busranurkocak/EE463-Term-Project/README.md

# EE463-Term-Project

Wind Turbine Controller (https://github.com/odtu/ee463/tree/master/Term%20Project)

Power Guide :Büşra Nur KOÇAK, Eren ÖZKARA, Yunus ÇAY
