busranurkocak/EE463-Term-Project/Reports/Presentationv3.pptx

## EE 463 Term Project Power guıde

Eren ÖZKARA
Büşra Nur KOÇAK
Yunus ÇAY

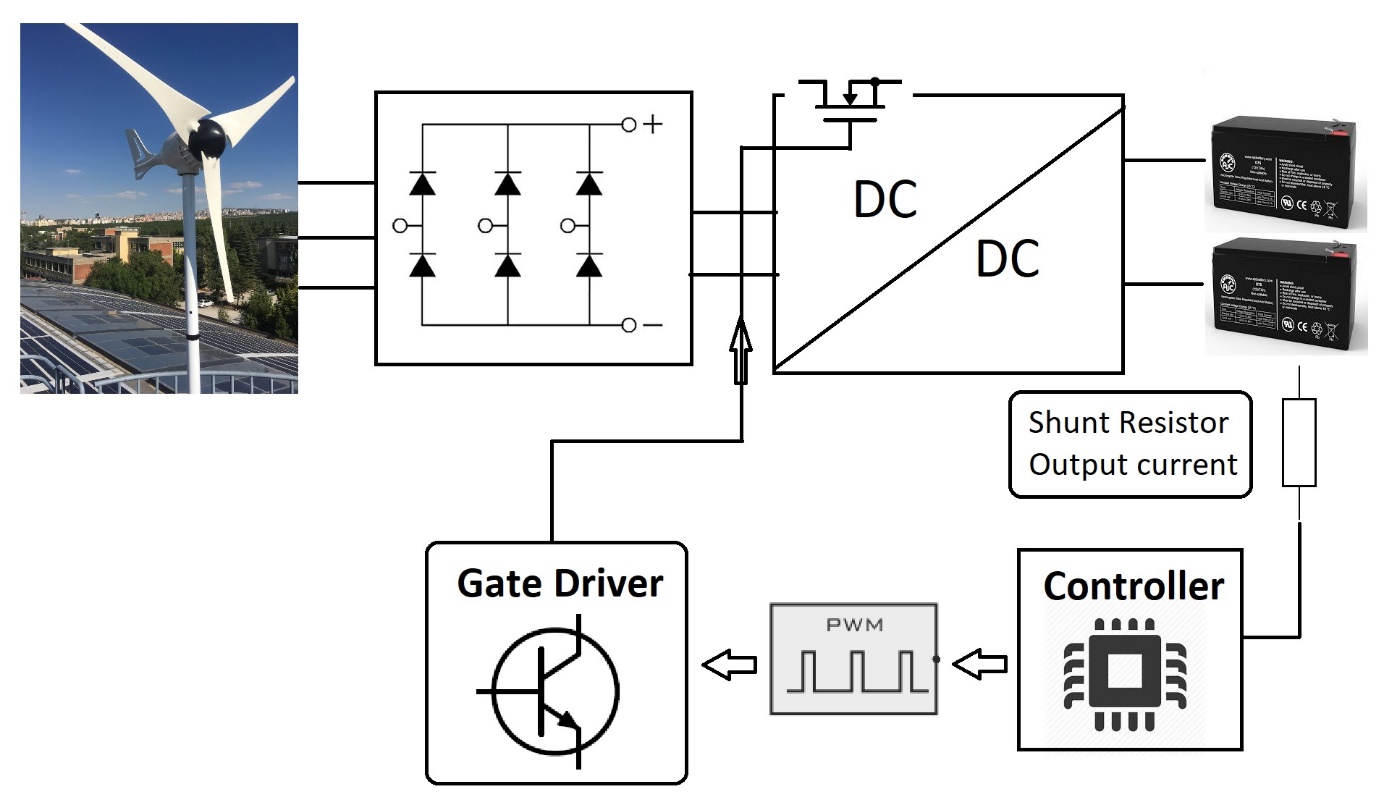
[picture p43: figure]

## ıNTRODUCTION

Topology Selection
Detailed Simulation
PCB Design
Component Selection
Conclusion

## Topology sELECTION

- Three Phase Thyristor Rectifier
+ Easy Topology Structure
+ Less Component
+ No Third Harmonics
- Expensive Components
- Six Gate Signals
- Complex Synchronous Control

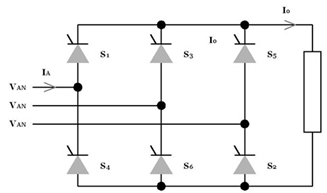
[picture p44: figure]
three-phase-full-wave-controlled-rectifier | AC-DC Power Converters | Electronics Tutorial || Electronics Tutorial

## Slide 4

- Three Phase Diode Rectifier with Buck Converter
+ One Gate Signal
+ Low Cost Compared to Controlled Rectifier
+ No Third Harmonics
- Theoretically Low Efficiency Compared to Controlled Rectifier
- High Size Due to LC filter

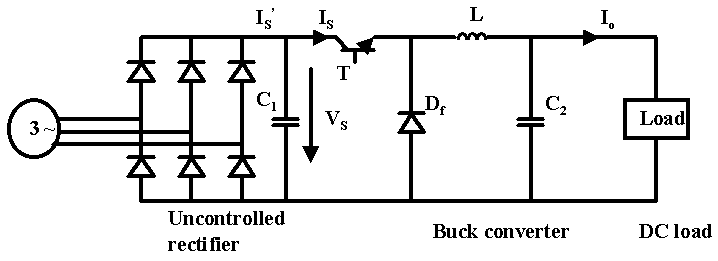
[picture p45: figure]
Uncontrolled six-diode bridge rectifier and buck converter. | Download Scientific Diagram

## Detaıled sımulatıon

- Uncontrolled Three Phase Rectifier
- Buck Converter
- Battery
- Controller
- Completed Simulation Results

## UnControllEd 3-Phase Rectıfıer

- Low output voltage ripple
- Simple
- Cheap
- Low conduction and switching losses

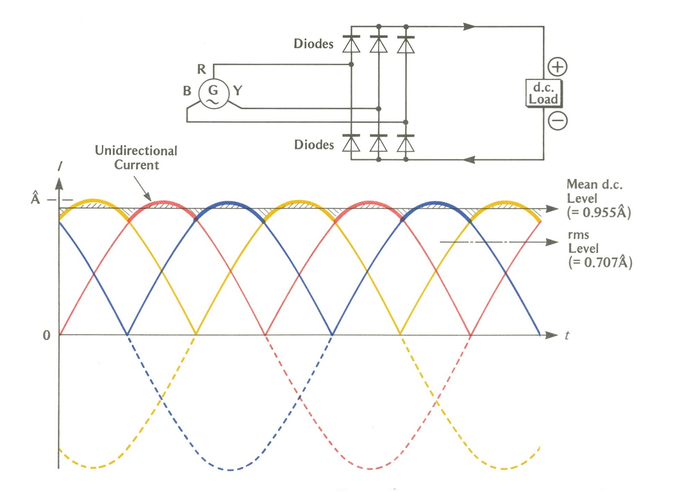
[picture p46: figure]
Six-pulse full-bridge rectifier: firing angle vs output voltage

## Slide 7

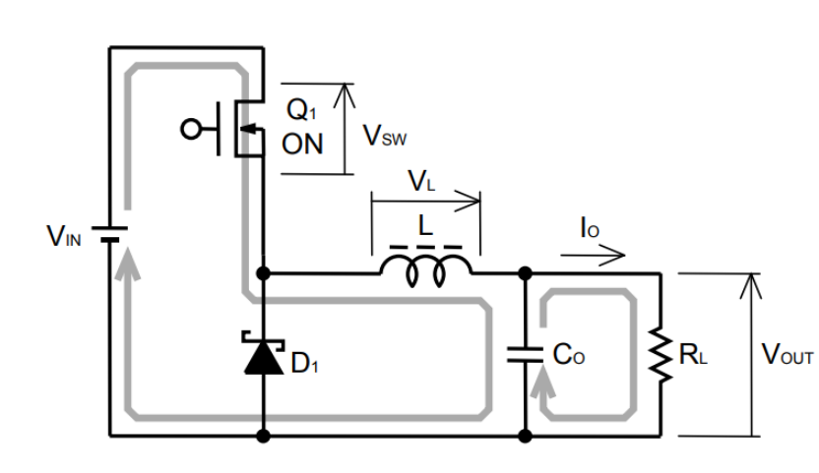
[picture p47: figure]

BUCK CONVERTER
L=((V_(IN) −V_(SW) −V_(OUT) )×(V_D +V_(OUT) ))/((V_(IN) −V_(SW) +V_D )×f_(SW) ×r×I_(OUT))
C_o = 1/(8∗f_(sw) ∗((∆V)/(∆I_L)−ESR))

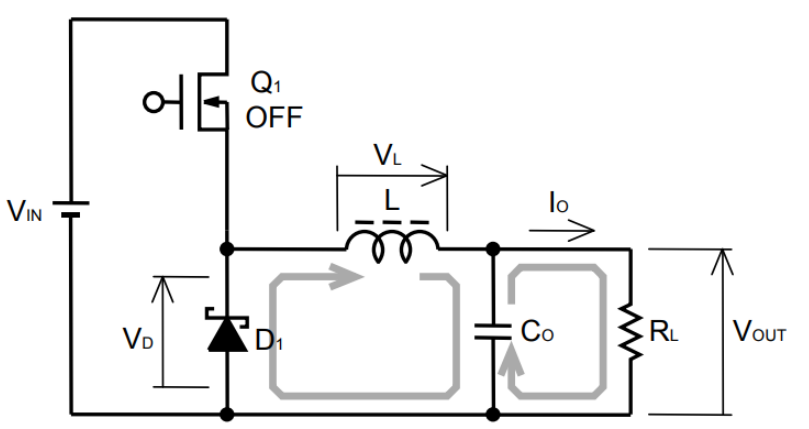
[picture p48: figure]

## Slide 8

Output Current Ripple


## Non-Synchronous & Synchronous Buck Converter

- Conduction losses

- Switching losses

Switch | Type | Conduction Loss
High-side | MOSFET | P_(cond,H) =D∗I_(O,AVG)^2 ∗R_(DS,ON)
High-side | IGBT | P_(cond,H) =D∗I_(O,AVG) ∗V_(CE)
Low-side | MOSFET | P_(cond,L) =(1−D)∗I_(O,AVG)^2 ∗R_(DS,ON)
Low-side | IGBT | P_(cond,L) =(1−D)∗I_(O,AVG) ∗V_(CE)
Low-side | Diode | P_(cond,L) =(1−D)∗I_(O,AVG) ∗V_(FD)

Switch | Type | Switching Loss
High-side | MOSFET | P_(SW,H) =V_(in) ∗I_O ∗f_(sw) ∗(Q_g)/(I_g)
Low-side | Diode | P_(SW,L) =f_(sw) ∗V_(in) ∗Q_(rr)

## Battery

- Constant Voltage Test

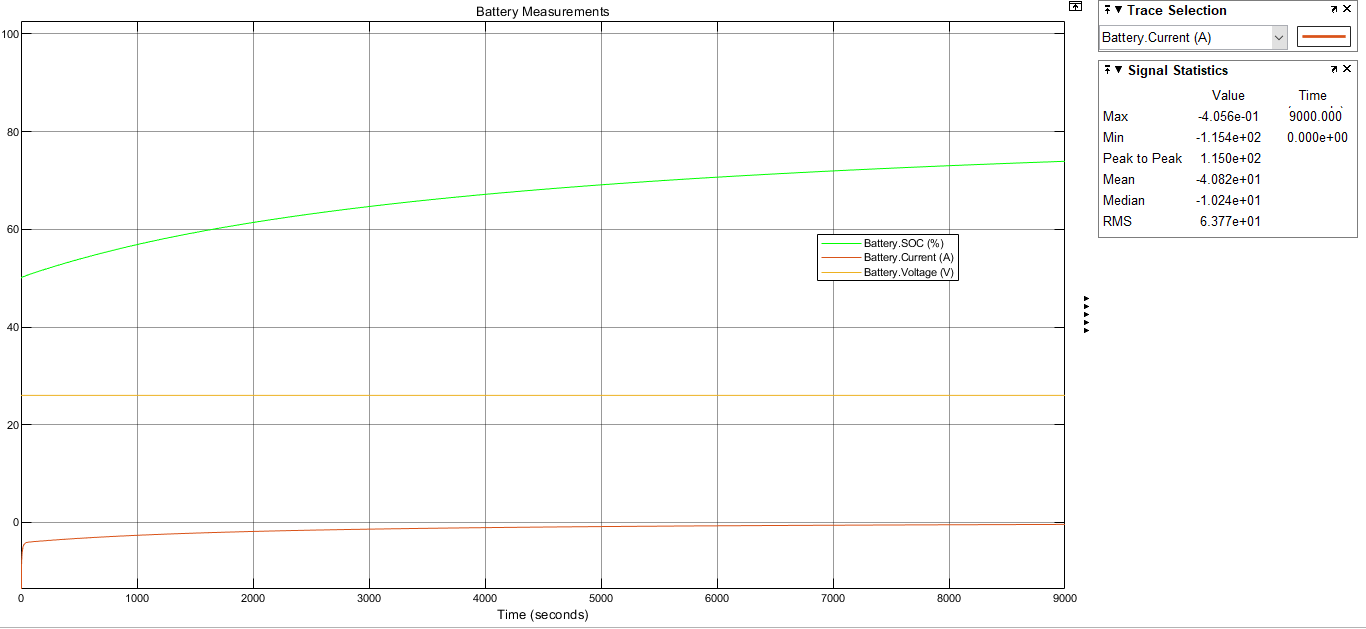
[picture p49: figure]
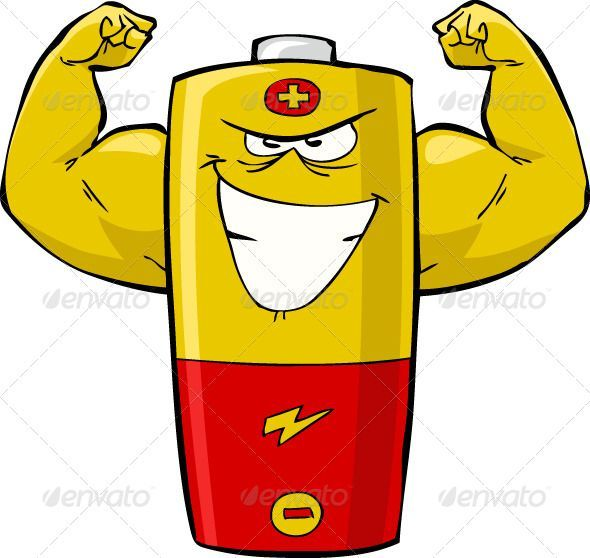
[picture p50: figure]
Realistic Graphic DOWNLOAD (.ai, .psd) :: hardcast.de/... ... Strong Battery ...... - #EnerjiDepolama | Fun illustration, Illustration design, Graphic design art

## Slide 11

- Constant Current Test

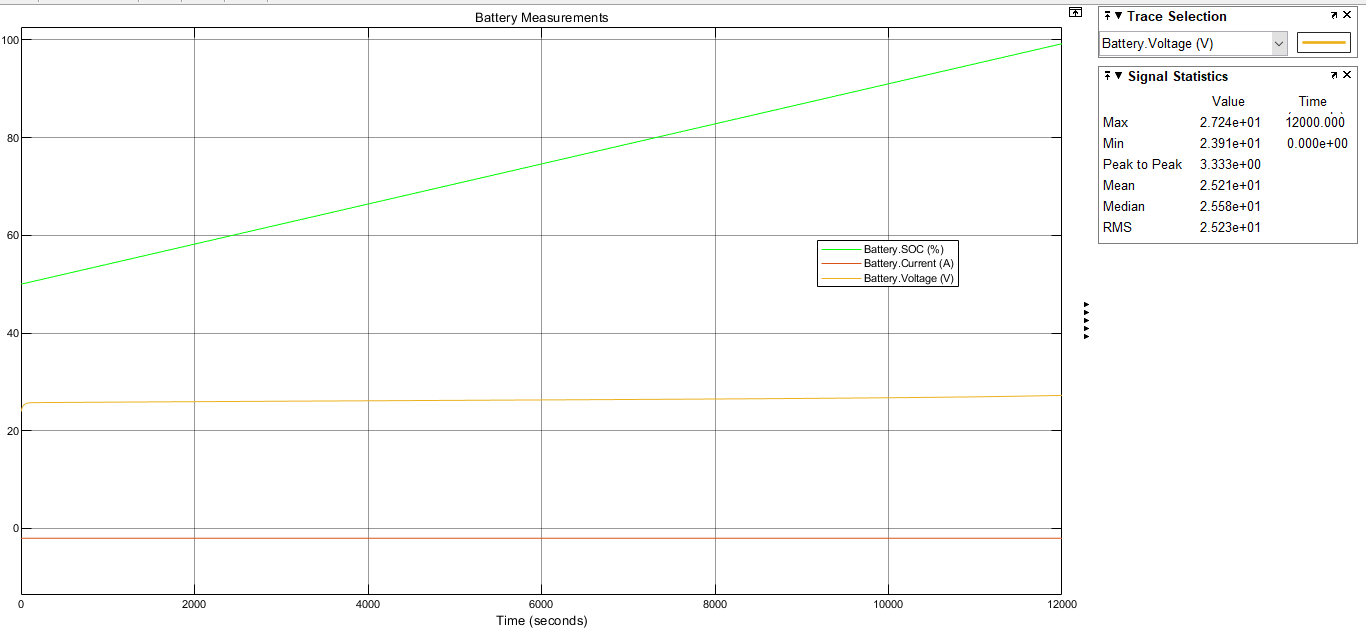
[picture p51: figure]

## Slide 12

- Battery with Buck Converter

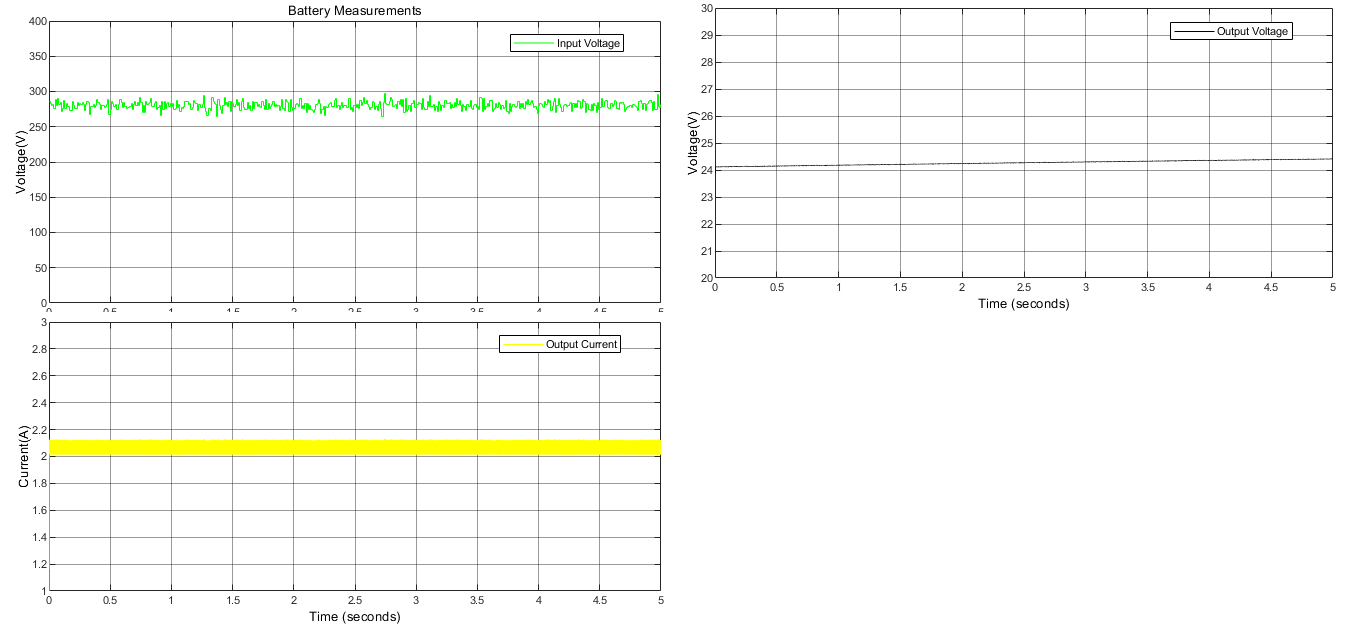
[picture p52: figure]
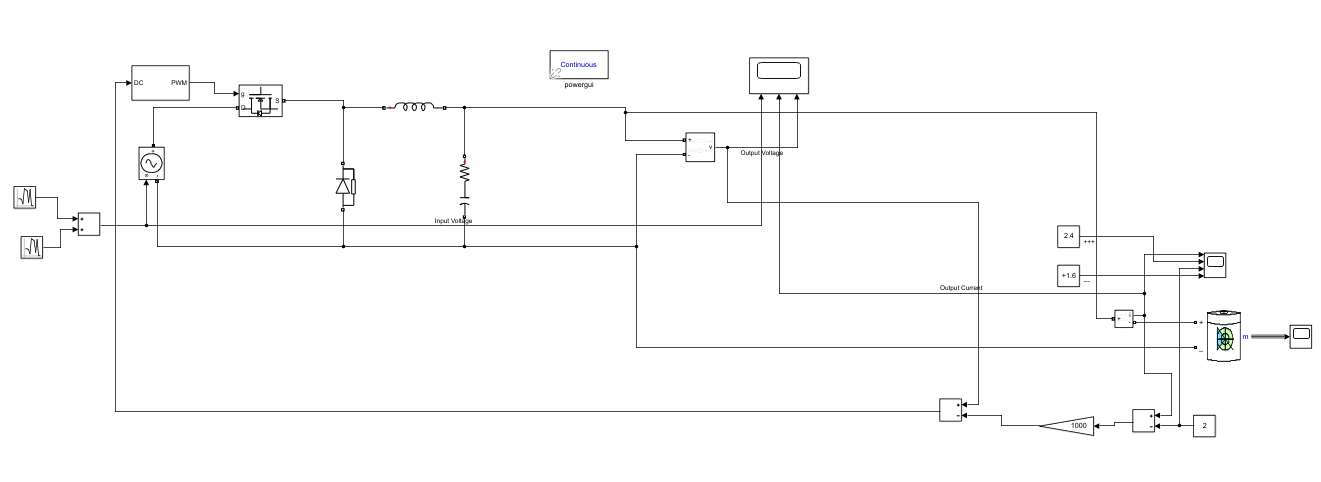
[picture p53: figure]

## Completed sımulatıon

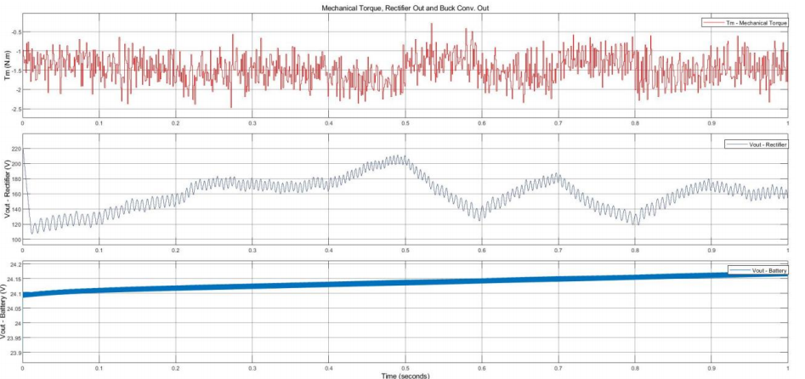
[picture p54: figure]

## OUTPUT CURRENT OF THE COMPLETED SIMULATION

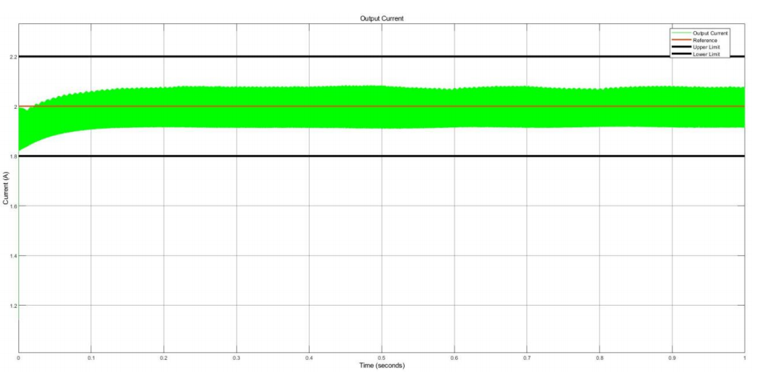
[picture p55: figure]

## CONTROLLER

- Switcher
  - Input voltage range
- External regulator
- MCU + Gate driver
  - Isolation
  - External supply

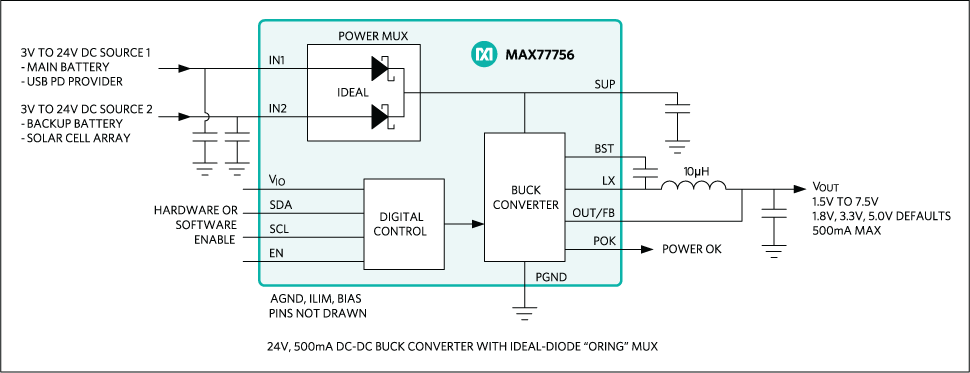
[picture p56: figure]
MAX77756: Simplified Block Diagram

## AL9910A LED DRIVER

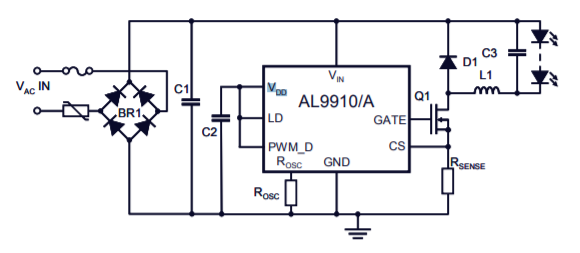
[picture p57: figure]

- Low cost
- Simple application
- Small volume
- No isolation and external supply

## Pcb dESIGN

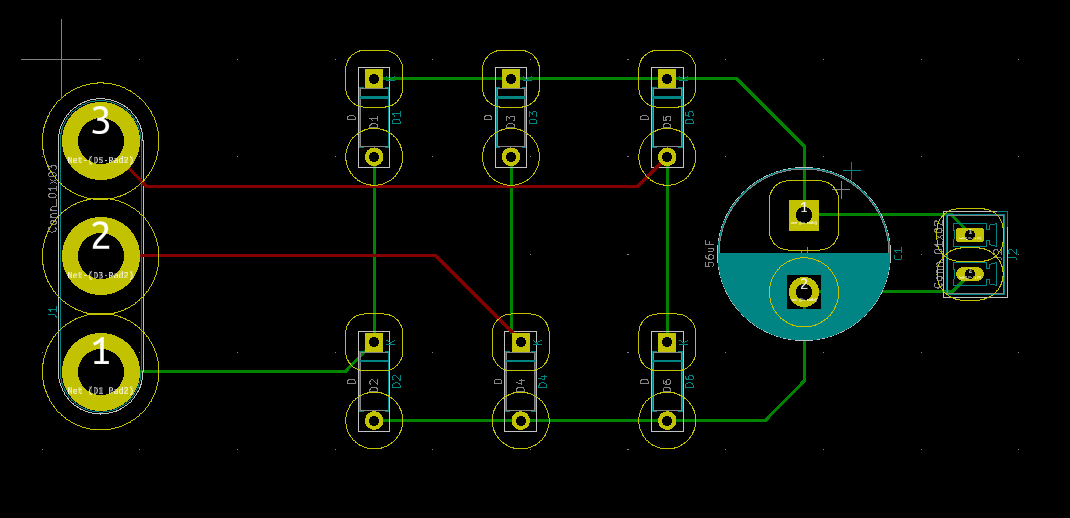
[picture p58: figure]
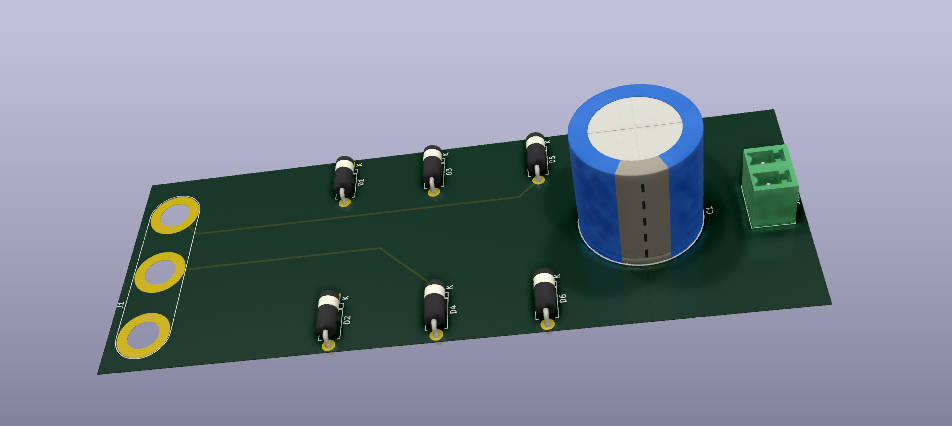
[picture p59: figure]

## Pcb Desıgn consıderatıon

- Footprints
- Trace spacing with respect to IPC2221 standards
- Trace width with respect to IPC2221 standards
- Space for heatsinks
- PCB thickness with respect to used component datasheet.
- Control traces in inner layer
- Traces with 45 degree angles
- Silk layer for more descriptive design
- Nodes

## COMponent Selectıon

- Rectifier Diode
- Rectifier Capacitor

Rectifier Diode | Reverse Voltage | Forward Current | Cost
S1G | 400V | 1A | 6x0.22$ = 1.32$

Rectifier Capacitor | Capacitance (µF) | Voltage Rating (V) | ESR (mΩ) | Price
MAL219856569E3 | 56 | 400 | 1706 | 3.9 $

## COMponent Selectıon

- LC Capacitor
- LC Inductor
- Freewheeling Diode
- Freewheeling Diode

| Capacitance (µF) | Voltage Rating (V) | ESR (mΩ) | Price
ESC686M035AE3AA | 68 | 35 | 220 | 0.30 $

| Inductance (mH) | Current Rating (A) | Saturation Current | Price
1140-272K-RC | 2.7 | 2.2 | 3.9 | 9.56 $
AIRD-03-152K | 1.5 | 2 | 3.4 | 5.52 $

Diode (Buck Conv) | VRRM | IF(AV) | VFD | Qrr | Cost
ES3G | 400V | 3A | 1.1V | 50nC | 0.18$
UF5404 | 400V | 3A | 1.0V | 8nC | 0.60$

## COMponent Selectıon

- MOSFET
- Gate Driver

| VDS (V) | RDS(on) (Ω) | ID (A) | Price($)
SPN04N60S5 | 600 | 0.95 | 0.8 | 0.986
IPU60R1K4C6 | 650 | 1.4 | 3.2 | 0.75
IPS60R1K0PFD7S | 650 | 1.0 | 4.7 | 0.63

| VIN | FSW | Cost
AL9910A | 520V | Up to 300kHz | 1.54€ = 1.88$

## Slide 22

Toroıdal shape cores
- Ferrite Cores
- Iron Powder Cores

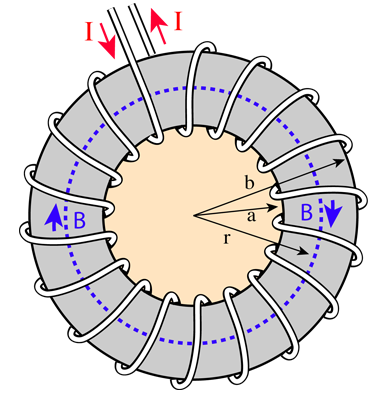
[picture p60: figure]

CABLE
- 22 AWG

## Conclusıon

Inductor Core Design
Control Circuit Design
Thermal Calculations
Thermal Simulations
PCB Designs
Project Video

## THANKS FOR LISTENING

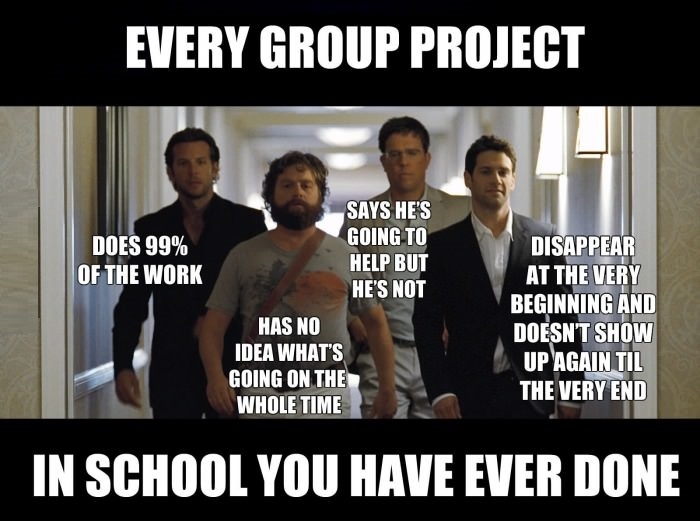
[picture p61: figure]
Every class project : funny
