busranurkocak/EE463-Term-Project/Reports/Presentationv1.pptx

## EE 463 Term Project

Eren ÖZKARA
Büşra Nur KOÇAK
Yunus ÇAY


## ıNTRODUCTION

Topology Selection
Detailed Simulation
PCB Design
Component Selection
Conclusion

## Topology sELECTION

- Three Phase Thyristor Rectifier
+ Easy Topology Structure
+ Less Component
+ No Third Harmonics
- Expensive Components
- Six Gate Signals
- Complex Synchronous Control

three-phase-full-wave-controlled-rectifier | AC-DC Power Converters | Electronics Tutorial || Electronics Tutorial

## Slide 4

- Three Phase Diode Rectifier with Buck Converter
+ One Gate Signal
+ Low Cost Compared to Controlled Rectifier
+ No Third Harmonics
- Theoretically Low Efficiency Compared to Controlled Rectifier
- High Size Due to LC filter

Uncontrolled six-diode bridge rectifier and buck converter. | Download Scientific Diagram

## Detaıled sımulatıon

- Uncontrolled Three Phase Rectifier
- Buck Converter
- Battery
- Controller
- Completed Simulation Results

## Battery

- Constant Voltage Test

Realistic Graphic DOWNLOAD (.ai, .psd) :: hardcast.de/... ... Strong Battery ...... - #EnerjiDepolama | Fun illustration, Illustration design, Graphic design art

## Slide 7

- Constant Current Test


## Slide 8

- Battery with Buck Converter


## Pcb dESIGN


## Pcb Desıgn consıderatıon

- Footprints
- Trace spacing with respect to IPC2221 standards
- Track width with respect to IPC2221 standards
- Space for heatsinks
- PCB thickness with respect to used component datasheet.
- Control traces in inner layer
- Traces with 45 degree angles
- Silk layer for more descriptive design
- Nodes

## Conclusıon

Inductor Core Design
Control Circuit Design
Thermal Calculations
Thermal Simulations
PCB Designs
Project Video

## THANKS FOR LISTENING

Every class project : funny
