busranurkocak/EE463-Term-Project/Video Slides/Photos for Video/Eren Presentation.pptx

## Power GuIde

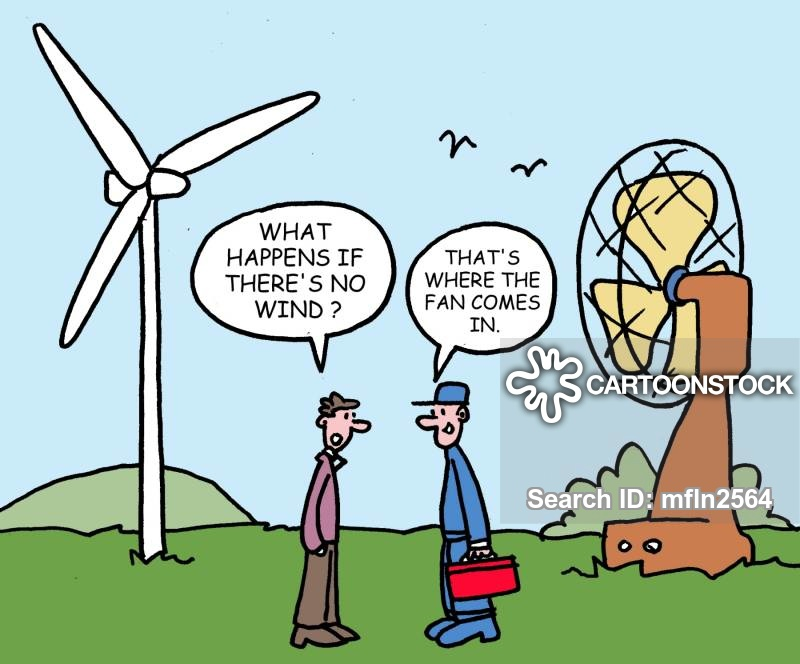
[picture p66: figure]
Wind Turbine Cartoons and Comics - funny pictures from CartoonStock

Eren ÖZKARA
Büşra Nur KOÇAK
Yunus ÇAY

## ıntroductıon

- Final Topology
- Simulation Results
- Component Selection
- Control System
- PCB Design
- Thermal Calculations
- Utilization Bonus
- Industrial Product Bonus
- Cheapest Design Bonus
- Thermal Simulation Bonus

## FINAL TOPOLOGY

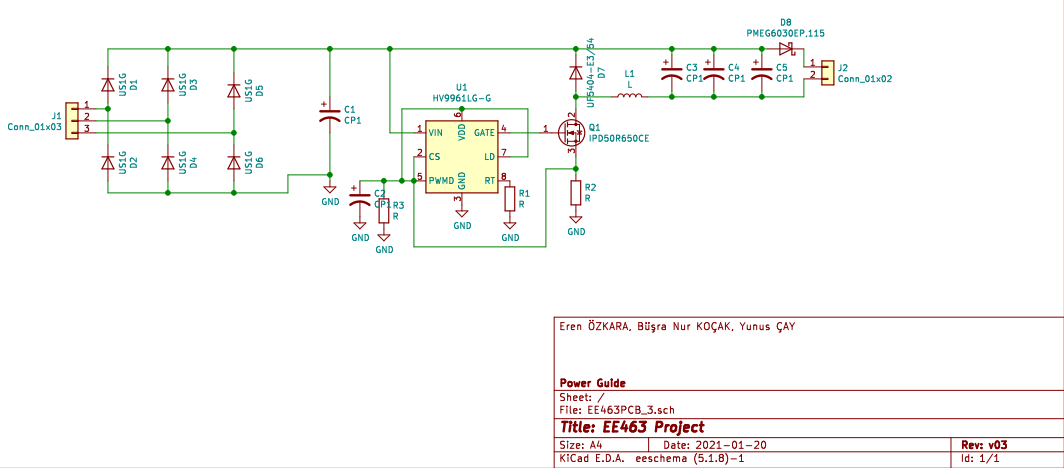
[picture p67: figure]

Figure 1. Final Topology of the Project

## Slide 4

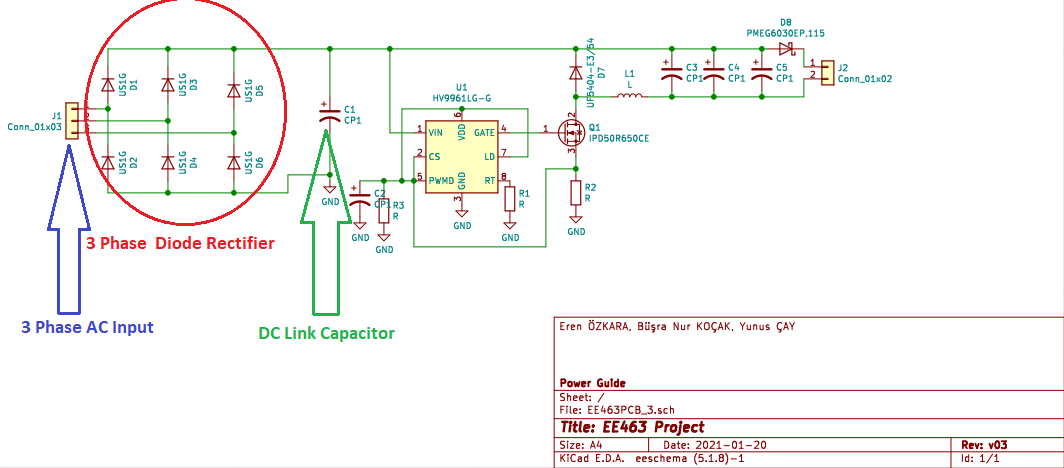
[picture p68: figure]

Figure 2. Rectifier Side of the Topology

## Slide 5

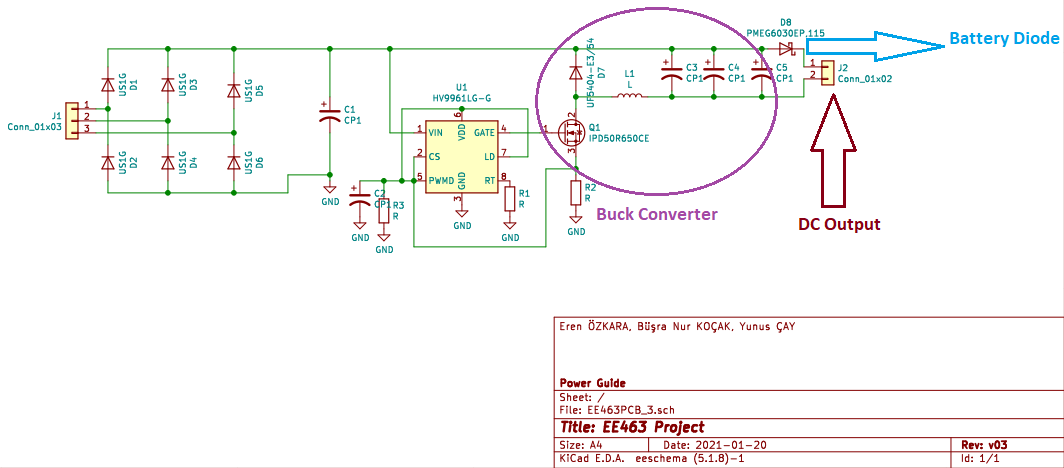
[picture p69: figure]

Figure 3. Buck Converter Side of the Topology

## Slide 6

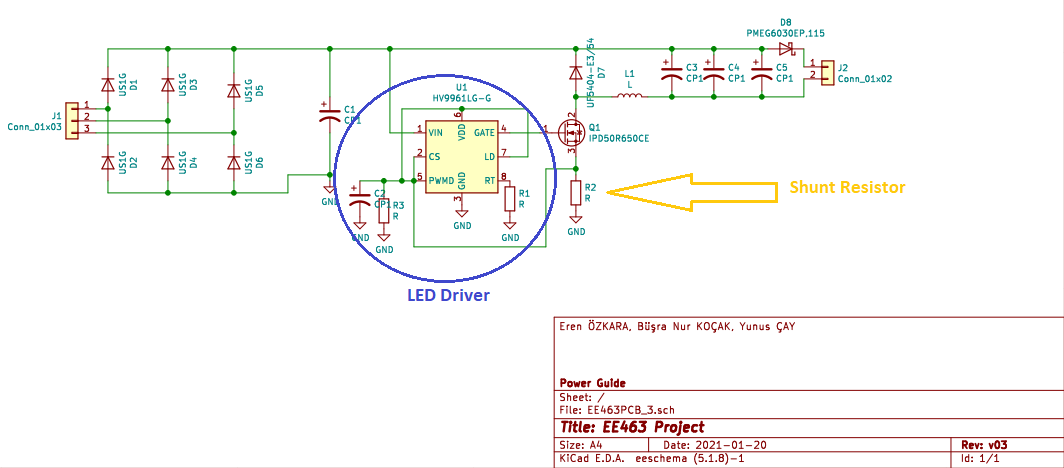
[picture p70: figure]

Figure 4. Controller Side of the Topology

## Component selectıon

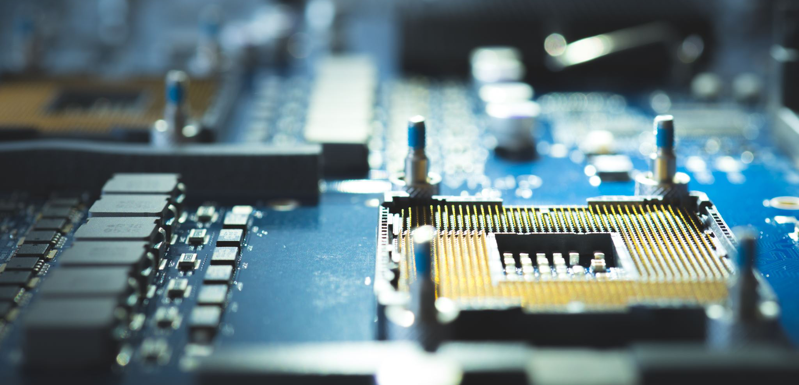
[picture p71: figure]
elektronik eşyalar, devre içeren bir resim Açıklama otomatik olarak oluşturuldu

## Rectıfıer dıode


Figure . Voltage and Current Waveforms of Rectifier Diode

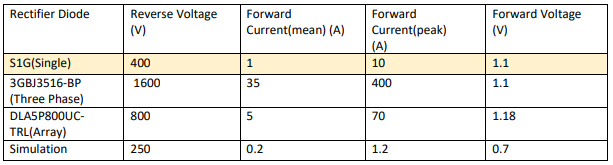
[picture p72: figure]

Table . Rectifier Diode Selection Table

## Slide 9

Dc lınk capacıtor


Figure . Voltage and Current Waveforms of DC Link Capacitor

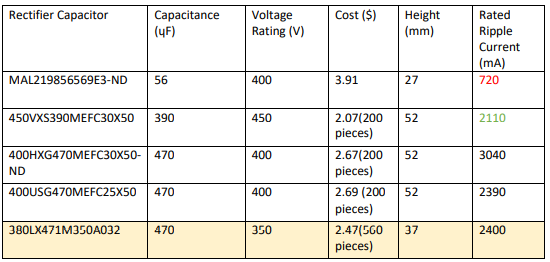
[picture p73: figure]

Table . DC Link Capacitor Selection Table

## Slide 10

Buck converter ınductor


Figure . Voltage and Current Waveforms of Buck Converter Inductor

Table . Buck Converter Inductor Selection Table

## Slide 11

BUCK CONVERTER CAPACITOR


Figure . Voltage and Current Waveforms of Buck Converter Capacitor

Table . Buck Converter Capacitor Selection Table

## Slide 12


Figure . Capacitance vs ESR graph for Buck Converter Output Capacitor

## Slide 13

Buck Converter dıode


Figure . Voltage and Current Waveforms of Buck Converter Diode

Table . Buck Converter Diode Selection Table

## Slide 14

BUCK CONVERTER SWITCH


Figure . Voltage and Current Waveforms of Buck Converter MOSFET

Table . Buck Converter MOSFET Selection Table

## Slide 15

cONTROLLER

Table . Controller Selection Table

## Battery dıode

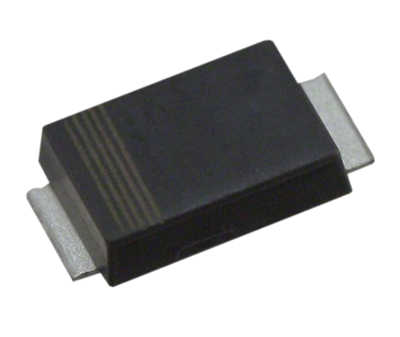
[picture p74: figure]

Table . Battery Diode Selection Table

## Slide 17

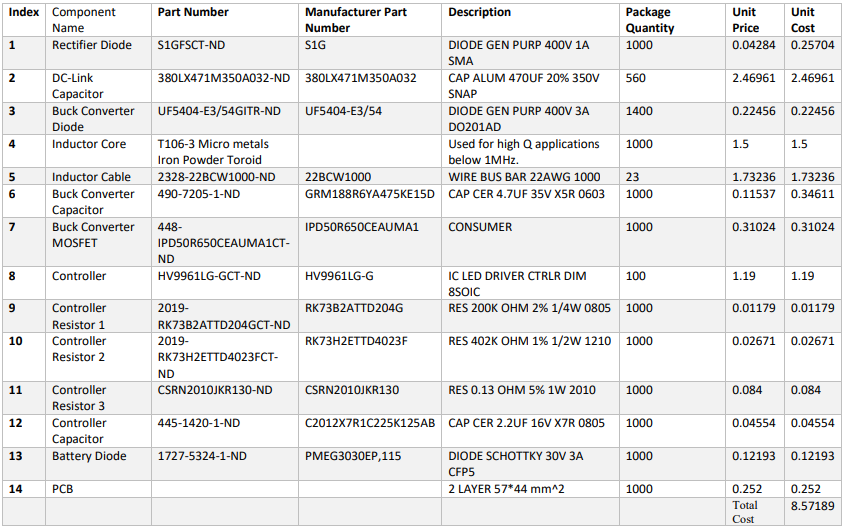
[picture p75: figure]

Figure . Bill of Materials

## Utılızatıon bonus

Table . Utilization Bonus Table

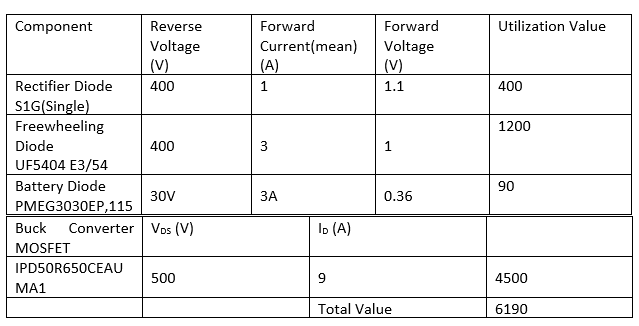
[picture p76: figure]
