busranurkocak/EE463-Term-Project/After Feedback/BOM.xlsx

Index | Component Name | Part Number | Manufacturer Part Number | Description | Package Quantity | Unit Price | Unit Cost
1 | Rectifier Diode | S1GFSCT-ND | S1G | DIODE GEN PURP 400V 1A SMA | 1000 | 0.04284 | 0.25704
2 | DC-Link Capacitor | 380LX471M350A032-ND | 380LX471M350A032 | CAP ALUM 470UF 20% 350V SNAP | 560 | 2.46961 | 2.46961
3 | Buck Converter Diode | UF5404-E3/54GITR-ND | UF5404-E3/54 | DIODE GEN PURP 400V 3A DO201AD | 1400 | 0.22456 | 0.22456
4 | Buck Converter Inductor | Iron Powder Toroid & Copper Cable | PowerGuide Inductor 1 | INDUCTOR 3-4.06 A | 1000 | 3.23 | 3.23
5 | Buck Converter Capacitor | 490-7205-1-ND | GRM188R6YA475KE15D | CAP CER 4.7UF 35V X5R 0603 | 1000 | 0.11537 | 0.34611
6 | Buck Converter MOSFET | 448-IPD50R650CEAUMA1CT-ND | IPD50R650CEAUMA1 | CONSUMER | 1000 | 0.31024 | 0.31024
7 | Controller | HV9961LG-GCT-ND | HV9961LG-G | IC LED DRIVER CTRLR DIM 8SOIC | 100 | 1.19 | 1.19
8 | Controller Resistor 1 | 2019-RK73B2ATTD204GCT-ND | RK73B2ATTD204G | RES 200K OHM 2% 1/4W 0805 | 1000 | 0.01179 | 0.01179
9 | Controller Resistor 2 | 2019-RK73H2ETTD4023FCT-ND | RK73H2ETTD4023F | RES 402K OHM 1% 1/2W 1210 | 1000 | 0.02671 | 0.02671
10 | Controller Resistor 3 | CSRN2010JKR130-ND | CSRN2010JKR130 | RES 0.13 OHM 5% 1W 2010 | 1000 | 0.084 | 0.084
11 | Controller Capacitor | 445-1420-1-ND | C2012X7R1C225K125AB | CAP CER 2.2UF 16V X7R 0805 | 1000 | 0.04554 | 0.04554
12 | Battery Diode | 1727-5324-1-ND | PMEG3030EP,115 | DIODE SCHOTTKY 30V 3A CFP5 | 1000 | 0.12193 | 0.12193
13 | PCB |  |  | 2 LAYER 57*44 mm^2 | 1000 | 0.252 | 0.252
 |  |  |  |  |  |  | 8.56953
