busranurkocak/EE463-Term-Project/After Feedback/PCBs/Busra/EE463PCB_2/EE463PCB.step

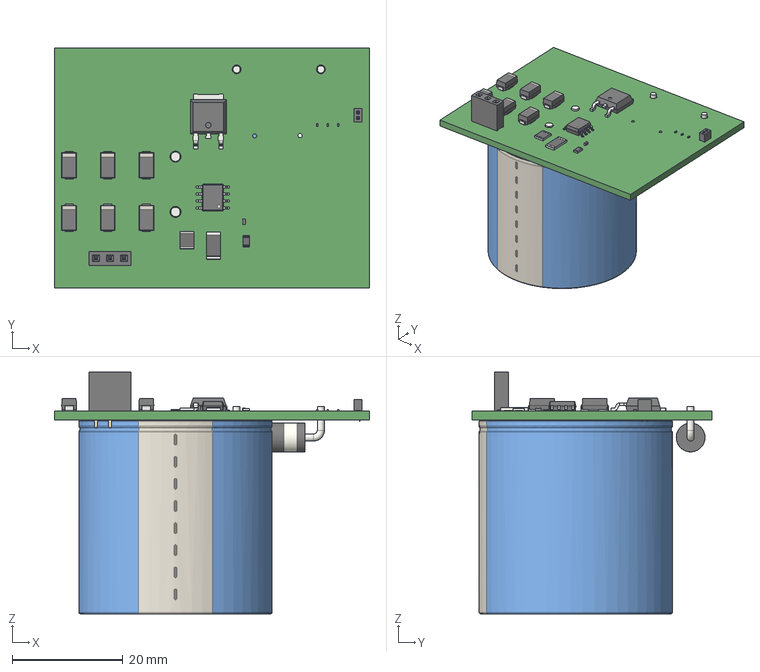
[picture p77: CAD file, 2021-01-14]
After Feedback/PCBs/Busra/EE463PCB_2/EE463PCB.step
57.0 x 43.5 x 43.7 mm
