busranurkocak/EE463-Term-Project/(list of files, cad)

Other CAD files:
After Feedback/PCBs/Busra/EE463PCB_5.step
After Feedback/PCBs/Busra/EE463PCB_4.step
