busranurkocak/EE463-Term-Project/Reports/EE463_TP_PowerGuide.pdf

## MIDDLE EAST TECHNICAL UNIVERSITY

## DEPARTMENT OF ELECTRICAL and ELECTRONICS ENGINEERING

## EE 463 – STATIC POWER CONVERSION I

## Term Project Report

### Eren Özkara 2232551

### Büşra Nur Koçak 1929355

### Yunus Çay 2166148

## Table of Contents

## 1. Introduction

In this report, topologies that can be used in the project were discussed and compared. Then the simulation details and the details of the topology used were explained. Equations used in design, analytical calculations and design decisions were mentioned. The progress steps of the design were explained. Then, the points to be considered while designing PCBs were discussed. Finally, the selected components and their properties were mentioned.

## 2. Topology Selection

In order to control the output current in the project, we need to use controlled rectifier or uncontrolled rectifier + buck converter topologies. Therefore, these topologies have been discussed.

### 2.1. Three Phase Thyristor

- Thyristor rectifier topologies are generally used in systems with high voltage and current.
- In this topology, the average output voltage of the thyristor rectifier can be controlled by adjusting the firing angle of the thyristors. Thus, output current can be adjusted with the firing angle.


Figure 1 Three Phase Thyristor Topology and its Output Voltage Equation

Advantages
- This topology consists of only 6 thyristors; therefore, the topology structure is not complex.
- In this topology, the input current THD is low because the third harmonics of the input current are not observed.

Disadvantages
- Although this topology contains only 6 thyristors, thyristors are expensive components compared to diodes.
- To control six thyristors at the same time, six gate drivers and other components are required, which increases the cost considerably.
- Operating and controlling 6 gate drivers synchronously is a very complex process.

### 2.2. Three Phase Diode Rectifier with Buck Converter

- DC / DC converters are used in many areas such as electrical vehicles, PV - Grid systems.
- In this topology, AC voltage will be converted to DC with an uncontrolled rectifier and then to the desired DC voltage value with a buck converter.
- In this topology, the duty cycle of the buck converter is controlled by sensing the output current.

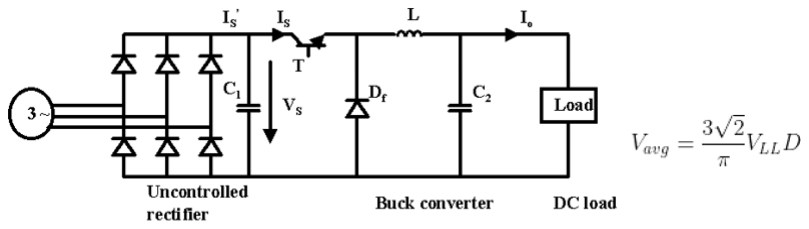
[picture p103: figure]

Figure 2 Three Phase Rectifier + Buck Converter Topology and its Output Voltage Equation

Advantages
- In this topology, the output voltage ripple can be easily reduced by placing a capacitor at the rectifier output and controlling the buck converter output voltage.
- This topology requires only one gate signal. This is a great advantage over controlled rectifiers. Also, the gate signal does not need to be synchronous.
- Although this topology requires more components, its cost is considerably lower than 3 phase-controlled rectifiers.
- In this topology, the input current THD is low because the third harmonics of the input current are not observed.

Disadvantages
- In this topology, its efficiency will theoretically be less since MOSFET and diode are used in addition to 3 phase-controlled rectifiers.
- Using an LC filter increases the size of the topology.

## 3. Detailed Simulation

### 3.1. Uncontrolled 3 Phase Rectifier

The modelled PMSM generator supplies three phase current to the system and 3-phase diode rectifier gives rectified signal as an output. The output voltage ripple is decreased with parallel capacitor which is place just before the buck converter. The modelled PMSM generator and rectifies can be seen in Figure 3. Input of generator is mechanical torque and other specifications of PMSM are provided in the project description.

The generated voltage difference on motor terminals depends on mechanical torque. Since the load current does not change, electrical torque of generator is constant, so difference between mechanical torque and electrical torque returns as a speed of shaft according to Equation (1). The constant electrical torque results in a significant observation about efficiency. Increase in the speed of rotor results in a more viscous friction loss. Hence, for constant output power applications are not efficient from the point of mechanical power and output power view.

Te = Tf + Bmw + Tm | (1)


Figure 3 Modelled PMSM generator and 3-phase FB diode rectifier

3-phase diode rectifier works without a control which is handled by characteristics of diode. The output voltage equals to the greatest line-to-line instantly. Since, the ripple frequency is six times of input line-to-line voltages, ripple is considerably low. The mean voltage of output without a dc-link capacitor is calculated in Equation (2). However, the output voltage is slightly less than generated voltage in generator due to commutation and stator resistance. While generator current results in a voltage drop on stator resistance, the armature reactance causes commutation.

Vmean =

3√6Vs,RMS
π

(2)

Output voltage ripple decreases as the pulse number of rectifiers increases. The 3-phase diode rectifier is called as 6-pulses rectifier. In addition to pulse number, DC-link capacitor filters out high frequency components of output voltage, so that the output voltage ripple decreases. Thus, the DC-link capacitor is placed just before the buck converter to decrease ripple as shown in Figure 3.

### 3.2. Buck Converter

General Structure and Calculations of Buck Converter

The DC voltage, which is the output of the three-phase full wave diode rectifier described in Part 3.1, have been connected into a buck converter to step down the voltage value from 250 V (Vmax) to 25 V nominal value for charging the battery. The main structure of the buck converter can be seen from the Figure 4. An approximate inductance and capacitance values have been calculated by specifying the on and off cases of switching element of the buck converter, which is MOSFET in this case.


Figure 4 Buck converter ON and OFF cases of the MOSFET

The output current of the buck converter is intended to be 2A with %20 of average current as ripple, while the battery is being charged. Therefore, ON and OFF states of the MOSFET have been considered separately for the same output current level to specify a formula for calculating required inductance value to apply intended output current ripple, Equation (3).

L =

(VIN − VSW − VOUT) × (VD + VOUT)

(VIN − VSW + VD) × fSW × r × IOUT

(3)

VIN: | Input Voltage (V)
VSW: | MOSFET ON state voltage drop (V)

VOUT: Output Voltage (V)

VD: | Diode forward voltage drop (V)
fSW: | Switching frequency (Hz)
r: | Output current ripple ratio

IOUT: MOSFET ON state voltage drop

The values specified above taken into consideration to calculate only an approximate inductance. According to these L have been calculated as 5.76 mH, which is known to be very high value for an inductor. The main reason for such high inductance is to decrease the ripple on the output current. Moreover, since the frequency value is located in the denominator as seen in the Equation (3) , the use of low frequency caused the inductor value to increase. Because, the ripple voltage already specified before, frequency is choosed to be the factor that can be changed to adjust the inductance value. Considering the effects of the frequencies in the 10 kHz- 100 kHz range on the conduction losses and switching losses, 50 kHz have been seen as a suitable value to reduce the inductor value by keeping the overall power loss level sufficiently low. Therefore, the inductor value have been achieved to decrease to 1.2 mH, which is 5 times less than the value calculated before, by changing the switching frequency with 50 kHz.

The conduction losses and switchign losses of switches are the most important parameters effecting efficiency of converter. Since the different step-down converter topologies are available, the switches are named as high-side and low side switch. While the high side switch represents the mosfet, low-side switch represents the diode for non-synchronous buck converter. The calculation of conduction losses for different type of switches are shown in Table 1.

Table 1 is used to decide step-down converter topologies between synchronous and non- synchronous converters. The duty cycle is taken as 0.1 for the sake of simplicity according to given mechanical torque values. Therefore, conduction losses of low-side switch is dominant. On the other hand, IGBT is eliminated due to increase in switching frequency. Whereas mosfets are generally used for high frequency and relatively low reverse voltage applications, IGBTs are chosen for low frequency and high reverse voltage applications.

All in all, the high-side switch is mosfet type and the low-side switch can be diode or mosfet. Although the type of low-switch affects the topology, the consideration of cost and efficiency is more important than driver characteristic and topology. Hence, low-switch is chosen as diode, which makes the converter non-synchronous.

Table 1 Conduction loss of high-side and low-side switches

Switch | Type | Conduction Loss
High-side | MOSFET | 2 Pcond,H = D ∗ IO,AVG ∗ RDS,ON
High-side | IGBT | Pcond,H = D ∗ IO,AVG ∗ VCE
Low-side | MOSFET | Pcond,L = (1 − D) ∗ IO,AVG 2 ∗ RDS,ON
Low-side | IGBT | Pcond,L = (1 − D) ∗ IO,AVG ∗ VCE
Low-side | Diode | Pcond,L = (1 − D) ∗ IO,AVG ∗ VFD

If switching loss of diode and mosfet were high compared to conduction loss, the selection of switch type could depend on switching loss and swithcing frequency. However, the switching loss of components are approximately 5 times less for mosfet and 3 times less for diode. The switching loss calculations can be seen in Table 2.

While gate driver current and gate charge are considered for mosfet, reverse recovery charge is considered as an important parameter for selection. Thus, gate driver is chosen as strong to supply high gate currents and type of diode is selected as fast diode.

Table 2 Switching loss of high-side and low-side switches

Switch | Type | Switching Loss
High-side | MOSFET | PSW,H = Vin ∗ IO ∗ fsw ∗ Qg Ig
Low-side | Diode | PSW,L = fsw ∗ Vin ∗ Qrr

While the inductor is effective in adjusting the output current ripple, capacitor plays an important role in output voltage ripple. Moreover, ESR of the capacitor which stands for ‘Equivalent Series Resistance’ is also an important factor while choosing a capacitor, as can be seen from the Equation (6), where ESL value is assumed to be 0 H. Both ON and OFF states of the MOSFET have been taken into consideration while analyzing the factors affecting the capacitor value.

∆VORPL = ∆IL (

1
8×CO×fSW

+ ESR) + ESL VIN(MAX)
L
[VP−P] | (4)

VIN(MAX)
: Maximum Input Voltage (V)

∆IL
: | Inductor ripple current (A)
CO: | Output capacitor (F)
ESR: | Equivalent series resistor of output capacitor (Ω)
ESL: | Equivalent series inductor of output capacitor (H)

The finilized approximation used in the capacitor calculations can be seen from Equation (6).

Co =

∆IL
8 ∗ fsw

∗

1

∆VORPL − ∆IL ∗ ESR − ESL ∗

Vin(max)
L

(5)

Co =

1

8 ∗ fsw ∗ (

∆V
∆IL

− ESR)

(6)

Hence, approximate capacitor value is calculated as 50 × 10⁻⁶ with 0.2 Ω ESR value. Because one of the most important parameters are specified as the ESR in output voltage ripple and capacitor calculations, it was decided to pay attention to the small ESR value, during the selection of capacitor. As the output voltage and current ripples of the converter is already specified before, an upper limit has been determined fort he ESR value.

Buck Converter Simulation with Estimated Values

An example circuit have been set, using the estimated values, which are calculated. The aim of this circuit is to show that the calculated inductor and capacitor values can reduce the input voltage level to the desired output voltage level with the specified ripple voltage. Moreover, inductor effect on output current waveform with the addition of a control system can be seen in Figure 6.


Figure 5 Buck converter Simulink circuit with PI controller


Figure 6 Output current measurement of the buck converter

### 3.3. Battery

In this part, battery part will be analysed, and some test will be applied.


Figure 7 Constant Voltage Battery Test

In this test, battery behaviour was observed when a constant voltage of 25 volts was applied to the battery. As can be seen from the graph, it is not enough to give constant input voltage to obtain constant current. Therefore, an increasing voltage must be applied to the battery.


Figure 8 Constant Voltage Battery Test

In this test, a constant input current of 2 amps was applied to the battery. As can be seen from the graph, an increasing voltage between 24-27 volts should be applied to the battery to charge from %50 to %100.


Figure 9 Buck Converter and Battery Test with P controller

In this test, the battery and buck converter part are connected. Buck converter's input is symbolized as noisy input with an average value of 280 V. In the test, an offset was observed in the output, so the P controls part will be converted into PI controls. Also, controller is simplified. In the following sections, all parts were combined with the rectifier and simulations were made in discrete time.

### 3.4. Controller

The selected topology has been designed as to control the desired average output current and ripple of output current by adjustments of duty cycle in buck converter. The block diagrams and input – output relations of blocks are shown in Figure 10. The measurement on shunt resistor is the feedback providing the system with current control. While Figure 10 shows the basic blocks and conceptual solution of control, other blocks such as isolation, amplifiers, comparators can be placed according to solution approach.

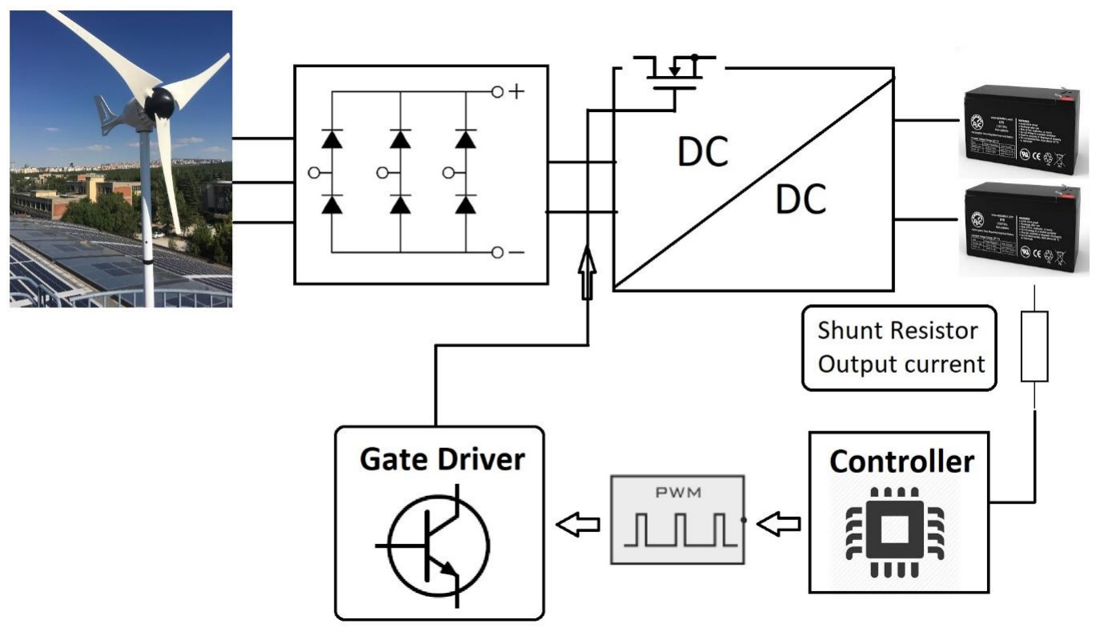
[picture p104: figure]

Figure 10 Block diagram of system and controller

The control of converters can be accomplished with some different ways. For instance, controller can be used digital controller such as arduino or programmable. Then, PWM generator and gate driver can be constructed externally. On the other hand, there are some integrated circuits which can handle analog control, PWM generation and gate driving in a single package. Moreover, some of them may include switching componenets, generally mosfets, are called switchers.

Each solution can the advantages and disadvantages in system level. For instance, external enhanced mcu can be used for applications requiring complex user interfaces or hard control algorithms. On the other hand, switchers can be used for converters with low input voltage for the sake of small volume. One of the packed controller can be seen in Figure 11. These are easy-to-use controllers.

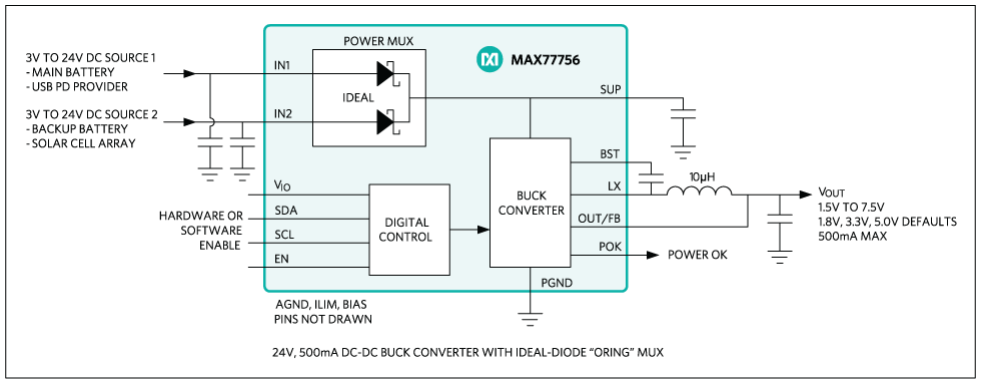
[picture p105: figure]

Figure 11 MAX77756 step-down controller, switcher example [1]

Before revealing the detail of the chosen solution approach for control, the requirements of the control and controller can be examined in Table 3.

Table 3 Requirements and significant considerations for selection of controller

Requirements | Value | Explanation
Input Voltage | ≥ 400V | Considered for internal regulators.
Switching frequency | 50kHz | PWM generation
Output current | ≥ 2A | Considered for internal regulators.
Isolation | NA | Safety of external digital controllers
Gate driving current | Depend on switch | Turn on time of switch
Threshold voltage | Depend on switch | Required min. Voltage to turn on switch
Feedback | Analog or digital | Sensed voltage or current information

The internal regulator ICs can not be used due to input voltage ratings of them and thermal considerations. Hence, usage of external switch is decided. On the other hand, digital controllers are considered as last choice due to isolation and external supply, which put the external analog regulators in a first place to find. Then, the research is focused on ICs that are generally used as LED drivers. As a result, AL9910A is selected as controller, PWM generator and gate driver. Figure 12 shows the typical application of AL9910A.

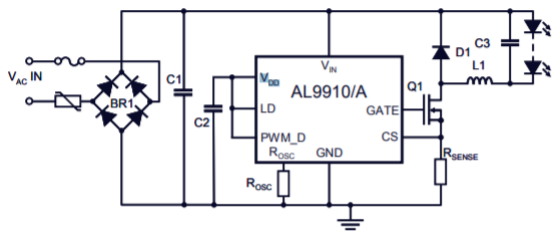
[picture p106: figure]

Figure 12 Typical application circuit of AL9910A

AL9910A controller does not need isolation and moreover, it eliminates external power supplies. “The AL9910 drives external MOSFETs at switching frequencies up to 300kHz, with the switching frequency determined by a single resistor. The AL9910 topology creates a constant current through the LEDs providing constant light output. The output current is programmed by one external resistor and is ultimately determined by the external MOSFET chosen and therefore allows many low current LEDs to be driven as well as a few high current LEDs.” [2]

### 3.5. Completed Simulation

The input mechanical torque, rectified output voltage and battery voltage can be seen in Figure 13.

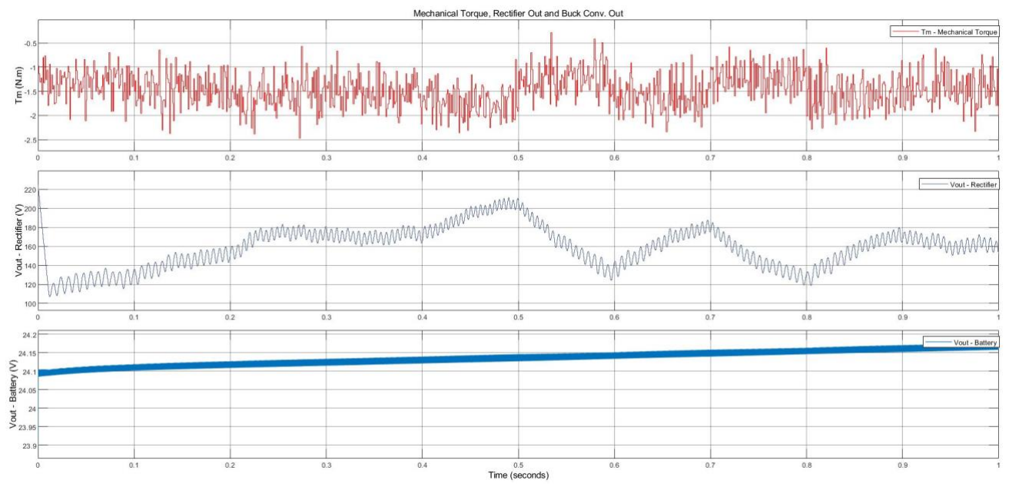
[picture p107: figure]

Figure 13 Complete Simulation, Tm, Vout-Rectifier & Vout-Battery

The output current, reference current and limiting values for ripple can be seen in Figure 14.

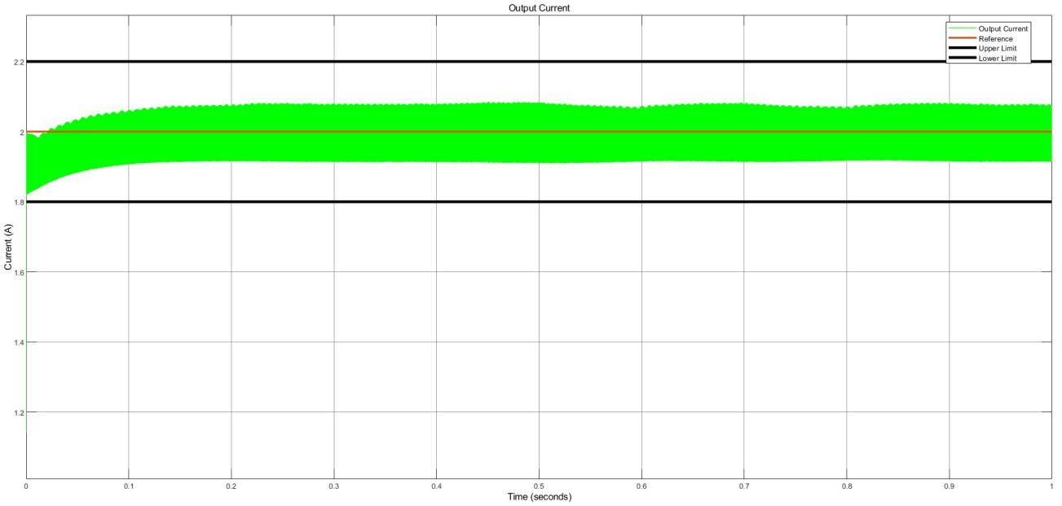
[picture p108: figure]

Figure 14 Complete Simulation, Output current, reference and limiting values

## 4. PCB Design

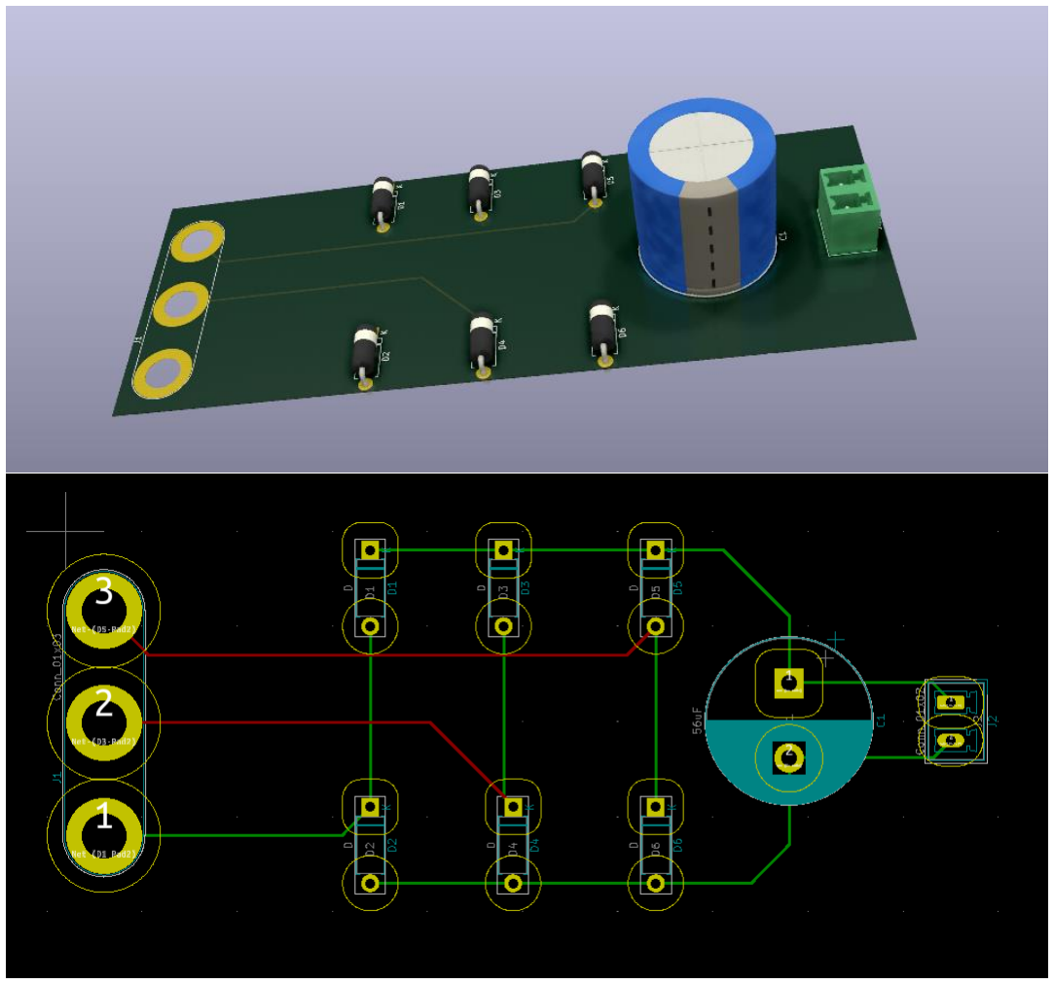
[picture p109: figure]

Figure 15 PCB Design of Uncontrolled Rectifier

In this part, the points we pay attention to while designing PCBs will be mentioned. Until now, only the PCB design of the rectifier part has been made for practical purposes. Because as the components used change, it can create big changes in PCB design. For example, thermal conditions have not yet been taken into consideration, but will be available in future designs.

- The footprint of the components will be added to the design by looking at the datasheet. If that footprint is not already available in the program library used, the footprint will be created.

- Considering high voltage conditions, suitable trace spacing will be left according to IPC2221B standards.
- Space will be left for the heatsink, considering the components that consume high power.
- The appropriate track width will be calculated considering the IPC2221 standard. Magnitude of the current should be considered because high current causes heating in traces.
- Silk layer will be used as much as possible to make the design more descriptive.
- PCB thickness will be as recommended in the datasheet of the components used. For example, 1 oz / ft²
is chosen for the rectifier.
- If necessary, control traces will be drawn on the inner layer to avoid noise.
- 90-degree angles will be avoided while drawing traces. Because this reduces the trace thickness, 45-degree angles should be used instead.
- If necessary, nodes will be made at important points.

## 5. Component Selection

### 5.1. Component Selection for Buck Converter

Rectifier

The diode rectifier is constructed with single diodes. The seperate usage has advantages in terms of cost and fault. The production of single diodes can be manufactured in huge amonts, which can provide them with low cost. Also, single diodes can be replaced easily.

The important parameters are breakdown voltage and forward current ratings. There is no need to fast diodes because the electrical frequency of generator cannot excess the 60Hz due to small pole-pair number. The selected rectifier diode is shown in Table xxx

Table 4 Rectifier component selection

Rectifier Diode | Reverse Voltage | Forward Current | Cost
S1G | 400V | 1A | 6x0.22$ = 1.32$

Inductor

The main point while choosing an inductor is its current ratings in addition to inductance. Eventhough, 2A average values expected on top of the inductor, It was observed in … that the current value on the inductor can reach peak values of 2.15 A. Therefore, special attention has been given to the saturation curretns during the selection of the inductor. The inductor models which use ferrite core as magnetic material have been preferred due to their ability to operate at higher frequencies and allowing higher inductor values with smaller size. Two different inductor values have been compared to determine the advantages and disadvatanges each have.

Table 5 Inductor component selection

| Inductance (mH) | Current Rating (A) | Saturation Current | Price
1140-272K-RC | 2.7 | 2.2 | 3.9 | 9.56 $
AIRD-03-152K | 1.5 | 2 | 3.4 | 5.52 $

Eventhough, high inductance value can decrease the output current ripple even further, considering the price of 1140-272K-RC, choosing AIRD-03-152K evaluated to be more appropriate. When the %10 tolerance of the AIRD-03-152K also included, it can be said that this inductor will not cause any problem in providing the required inductance value fort he converter to supply current within the previously specified ripple current range.

Capacitor

One of the most important factors in capacitor selection is the ESR which value. It is already calculated in the Part 3.2 and an upper bound have been set as 0.25 due to the rating between output voltage and current ripple values. It can be also seen from the Equation (6) that the required capacitor value increases as the ESR value choosed to be close to 0.25. Therefore, capacitors with around 0.2 Ω ESR values tried to be compared according to their capacitance values and most importantly voltage ratings as capacitor should be able to charge at least until the value of converter output.

Table 6 Capacitor component selection

| Capacitance (µF) | Voltage Rating (V) | ESR (mΩ) | Price
ESC686M035AE3AA | 68 | 35 | 220 | 0.30 $

The selected capacitor, ESC686M035AE3AA, can be seen from the Table with its values seen as important.

Diode

As the diode will guide the converter during the OFF times of the MOSFET, which will be about %90 dur to the input and output voltage rate of the rectifier, it choosed to be super fast rectifier diode, which lowers the switching losses due to its fast reverse recovery time. While choosing diode, it should be also considered that the voltage rating accros it will be approximately around 400 V coming from the rectifier voltage.

Table 7 Diode component selection

Diode (Buck Conv) | VRRM | IF(AV) | VFD | Qrr | Cost
ES3G | 400V | 3A | 1.1V | 50nC | 0.18$
UF5404 | 400V | 3A | 1.0V | 8nC | 0.60$

MOSFET

The most important parameter while choosing a mosfet for switching applications is its Ron resistance to decrease conduction loss. Different type of mosfets have been compared and IPS60R1K0PFD7S have been found to be more suitable to use in the converter, considering its resistance and price.

Table 8 MOSFET component selection

| VDS (V) | RDS(on) (Ω) | ID (A) | Price($)
SPN04N60S5 | 600 | 0.95 | 0.8 | 0.986
IPU60R1K4C6 | 650 | 1.4 | 3.2 | 0.75
IPS60R1K0PFD7S | 650 | 1.0 | 4.7 | 0.63

Gate Driver

Gate driver has many parameters such as gate driver current, isolation, input voltage range, feedback and cost. These parameters can be satisfied few gate drivers. Hence, the gate driver is presented as a single in Table 9.

Table 9 Gate driver component selection

| VIN | FSW | Cost
AL9910A | 520V | Up to 300kHz | 1.54€ = 1.88$

Inductor Selection and Calculations

Ferrite Cores

Toroidal shape Ferrite core values have been examined as a starting point for designing the inductor for the buck converter with the specified rated values. One of the main properties of the ferrite cores is that their high permeability values, which increase flux density. Although it is quite easy to reach high inductor values with less winding, they have not seen as a reasonable option in high current applications because of their low saturation flux density, which is generally around 0.5 T. According to the Equation (7), since reducing the rated current is not an option and the radius value is limited by physical factors, the only option is to reduce the µ value to decrease operating flux density for allowing reasonable amount of N turns. Therefore, it has been considered appropriate to look at magnetic core materials with lower permeability and higher maximum flux density values. In case of ferrite core use, it has been decided to examine the changes in the case of including an air gap in the core design.

B =

μNI
2πr

, L =

NBA
I

(7)

Iron Powder Cores

Iron powder toroidal cores have much lower permeability and higher saturation flux density values comparing with the toroidal ferrite cores. When the variables seen in the Equation (7) are evaluated, the permeability decreases can only be caused by the increase in the number of turns. Even though keeping B value seems to be as desired due to the saturation effect, it makes that very difficult to reach the required level of inductance. Therefore, the problem with iron powder cores is requiring high number of turns.

Cable

The average and maximum current values passing through the inductor have been observed as 2 and 2.15, in Figure 14. Therefore, the cable thickness to be used in the inductor windings have been chosen as 22 AWG (American Wire Gauge), which is able to carry 3A of current trough it at 60° with 0.644 mm thickness.

## 6. Conclusion

In the ongoing project, inductor design will be made if it needed. Appropriate design will be applied for the selected controls. PCB designs will be made according to the points mentioned. Thermal simulation will be done, heatsink will be placed where necessary and thermal calculations will be made.
