busranurkocak/EE463-Term-Project/Battery/Battery PID tests.docx

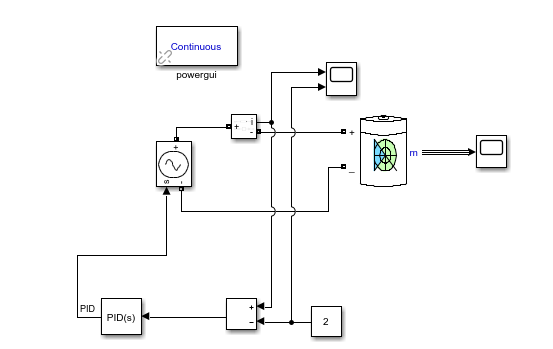
[picture p110: figure]
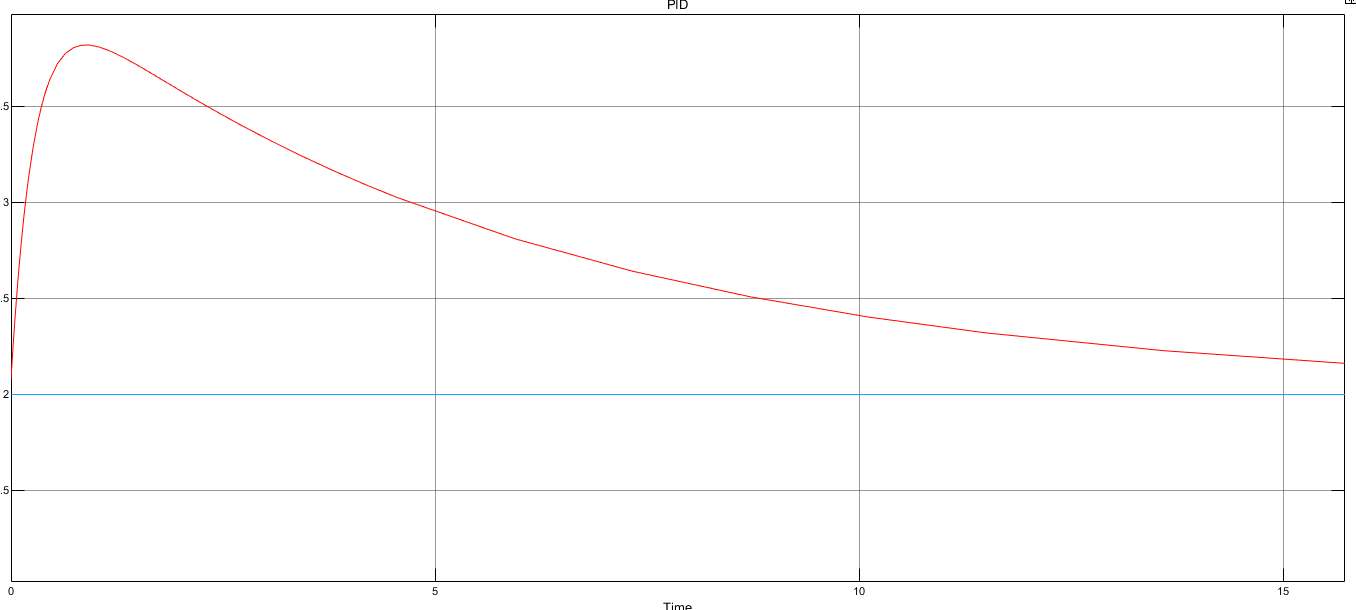
[picture p111: figure]
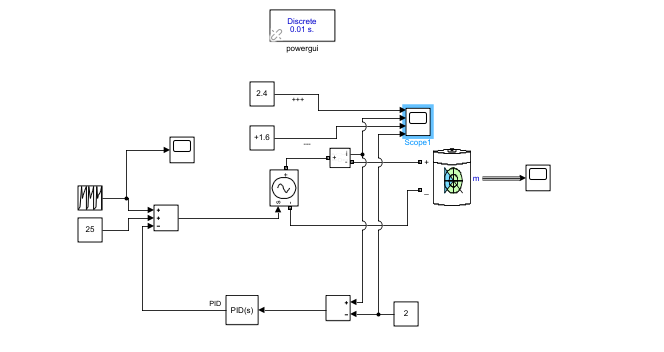
[picture p112: figure]
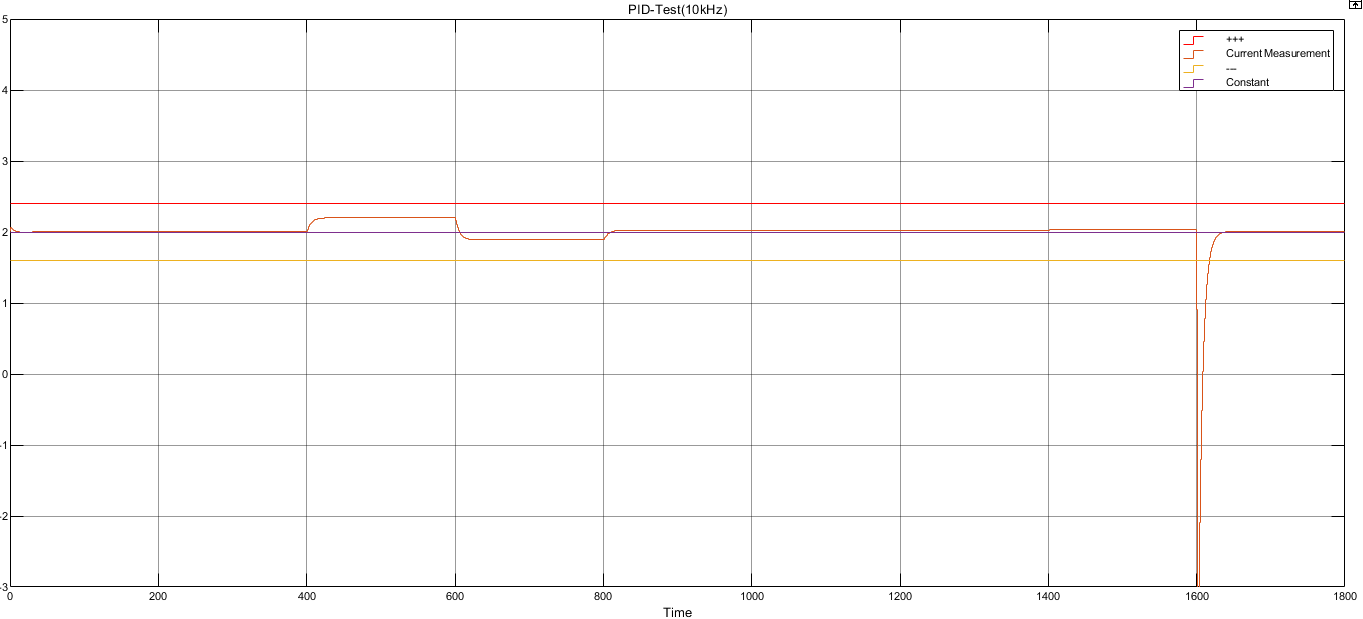
[picture p113: figure]
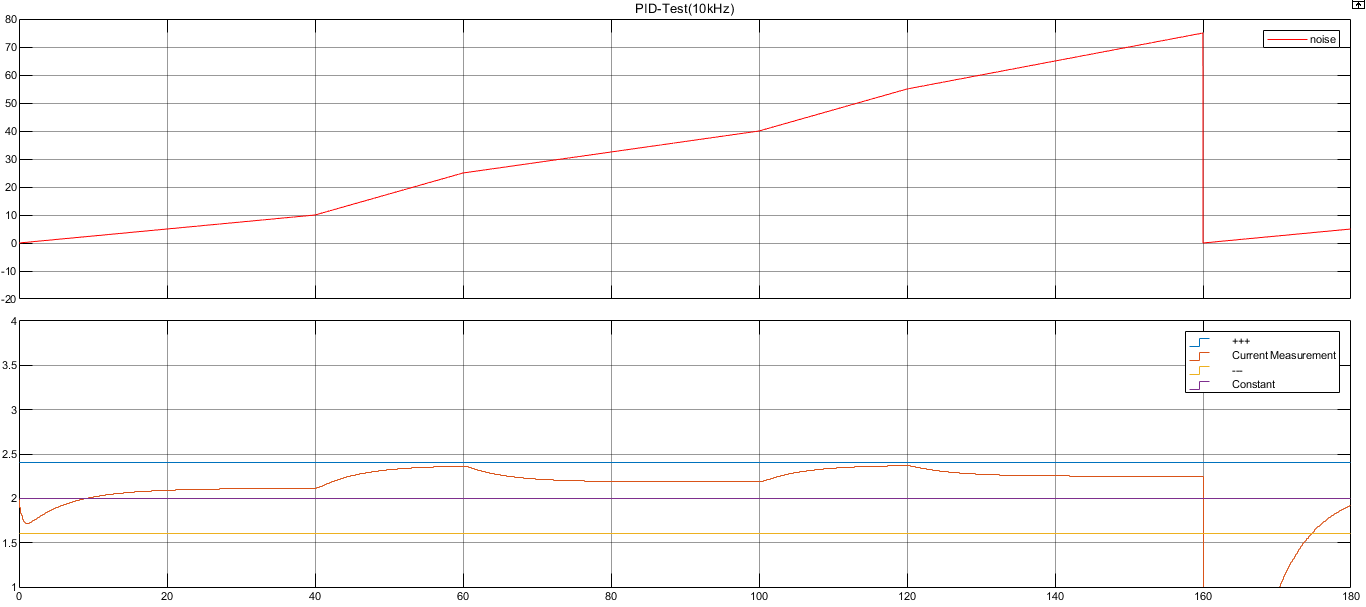
[picture p114: figure]
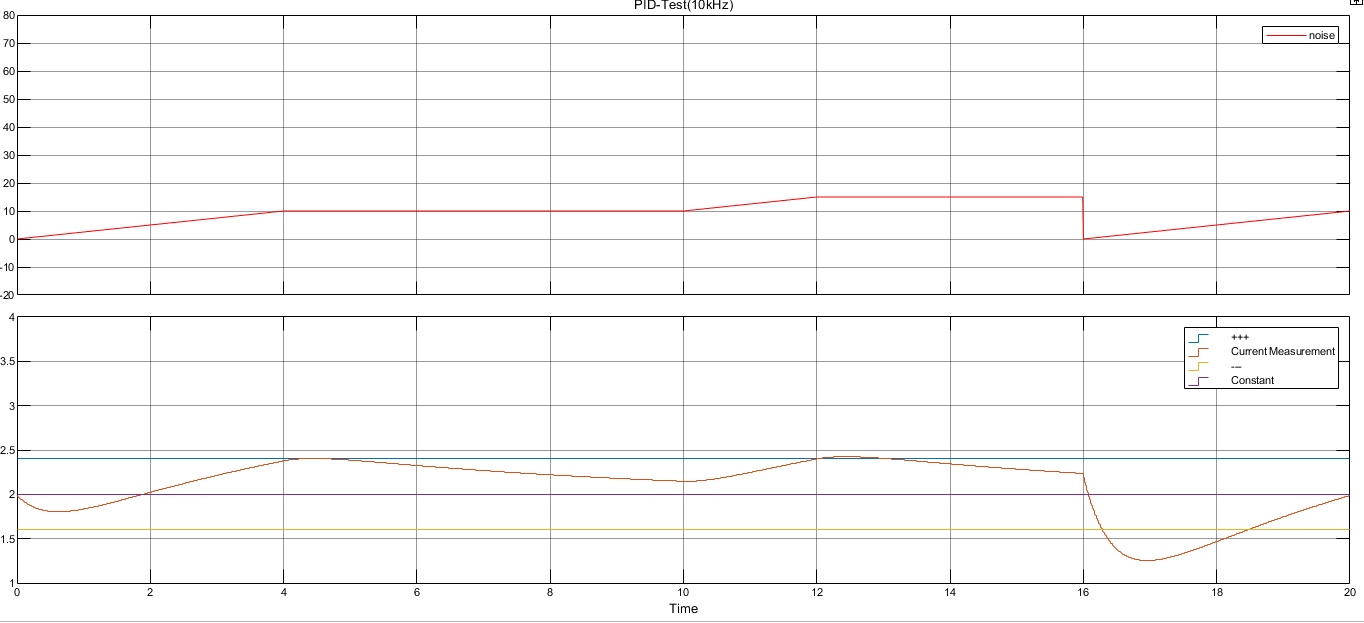
[picture p115: figure]
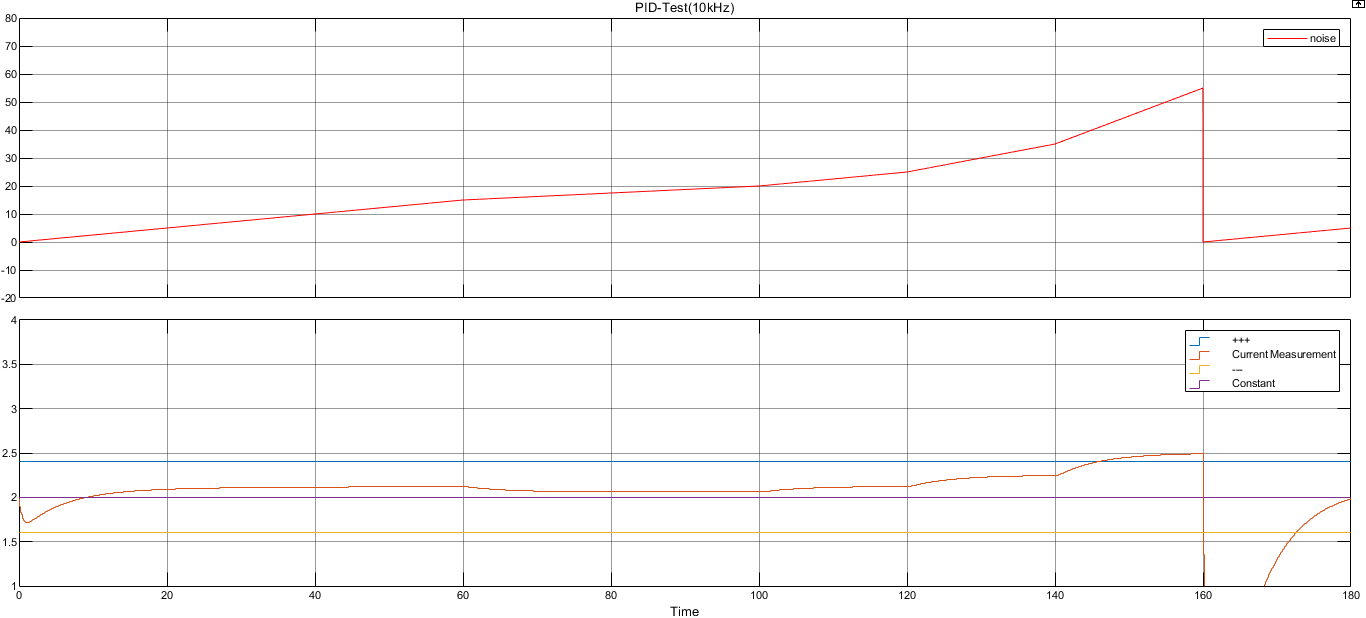
[picture p116: figure]
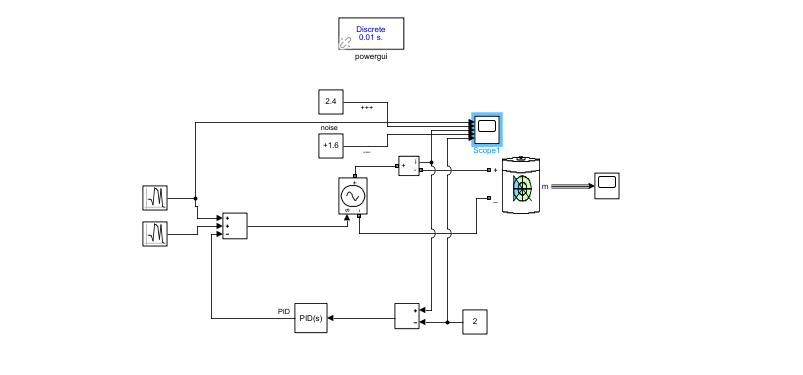
[picture p117: figure]
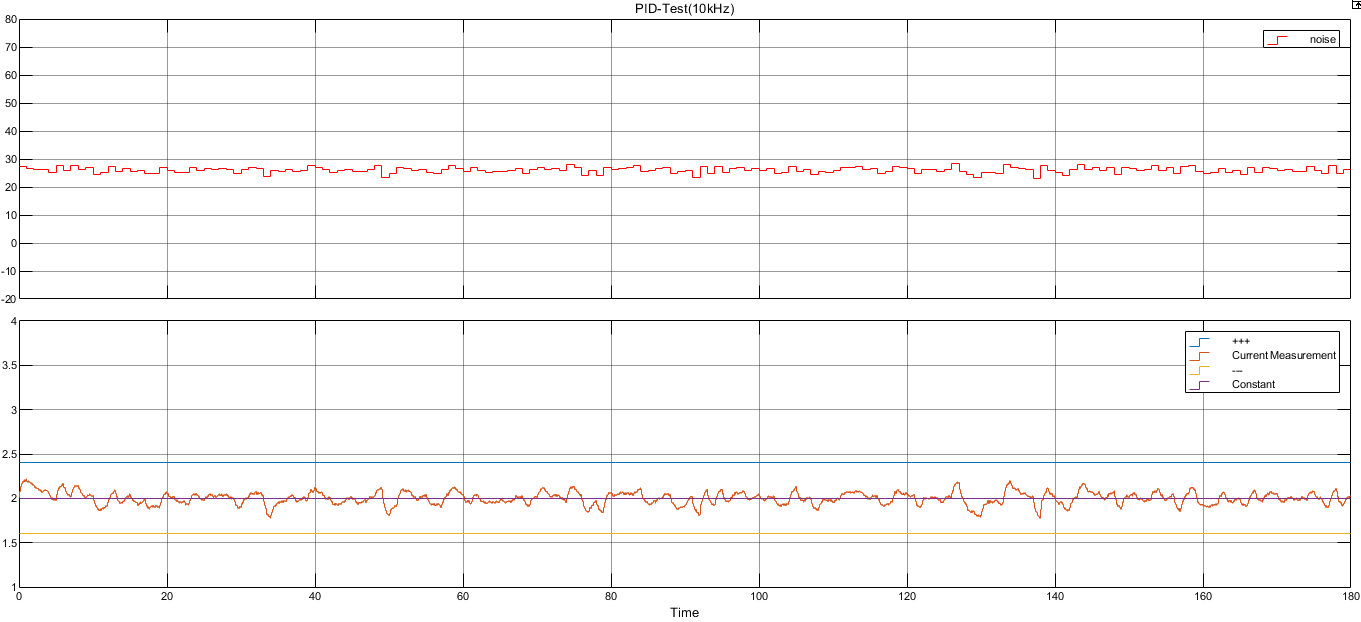
[picture p118: figure]
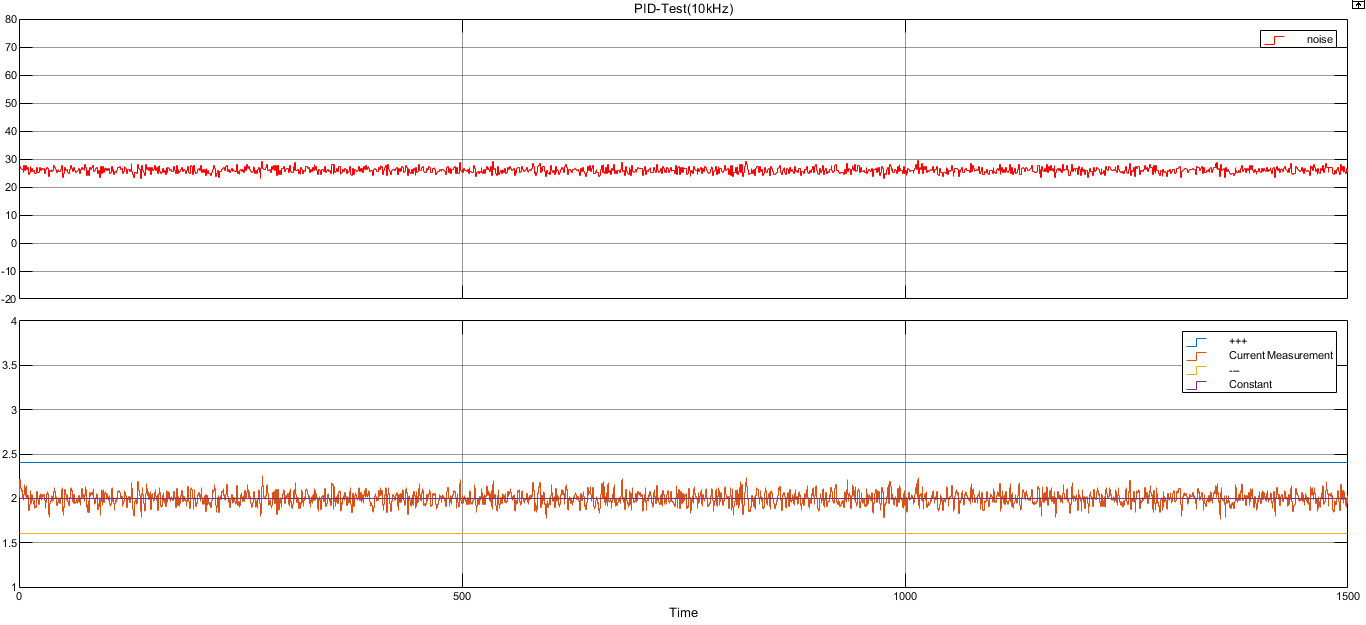
[picture p119: figure]
