busranurkocak/EE463-Term-Project/After Feedback/PCBs/Busra/EE463PCB_3/dasd/EE463PCB_3.pdf

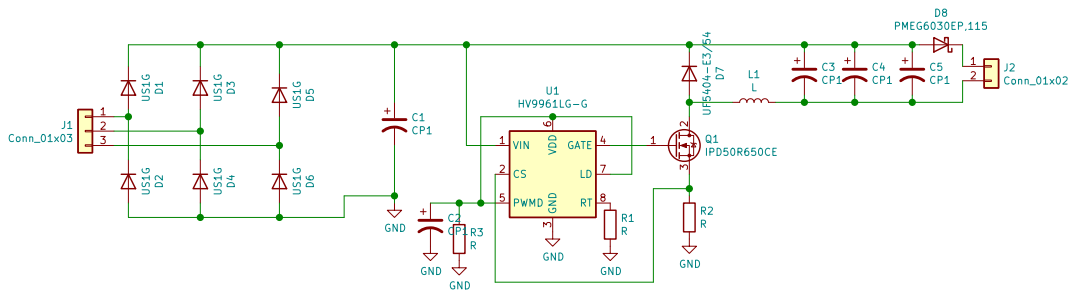
[picture p120: page 1]

File: EE463PCB_3.sch Sheet: / Power Guide Eren OZKARA, Büra Nur Koçak D2 US1G
