busranurkocak/EE463-Term-Project/After Feedback/PCBs/Busra/EE463PCB_3/EE463PCB_3.kicad_pcb

## KiCad design After Feedback/PCBs/Busra/EE463PCB_3/EE463PCB_3.kicad_pcb (2021-01-14)

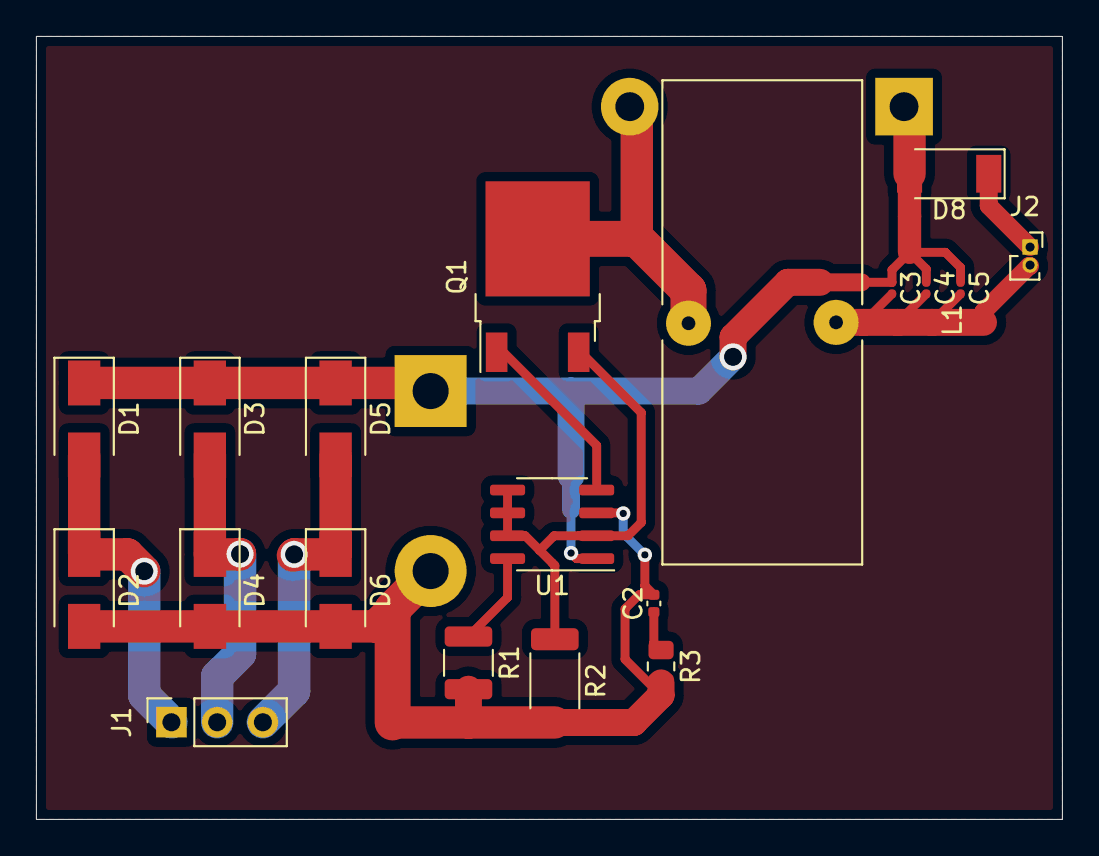
[picture p121: board EE463PCB_3.kicad_pcb from above]

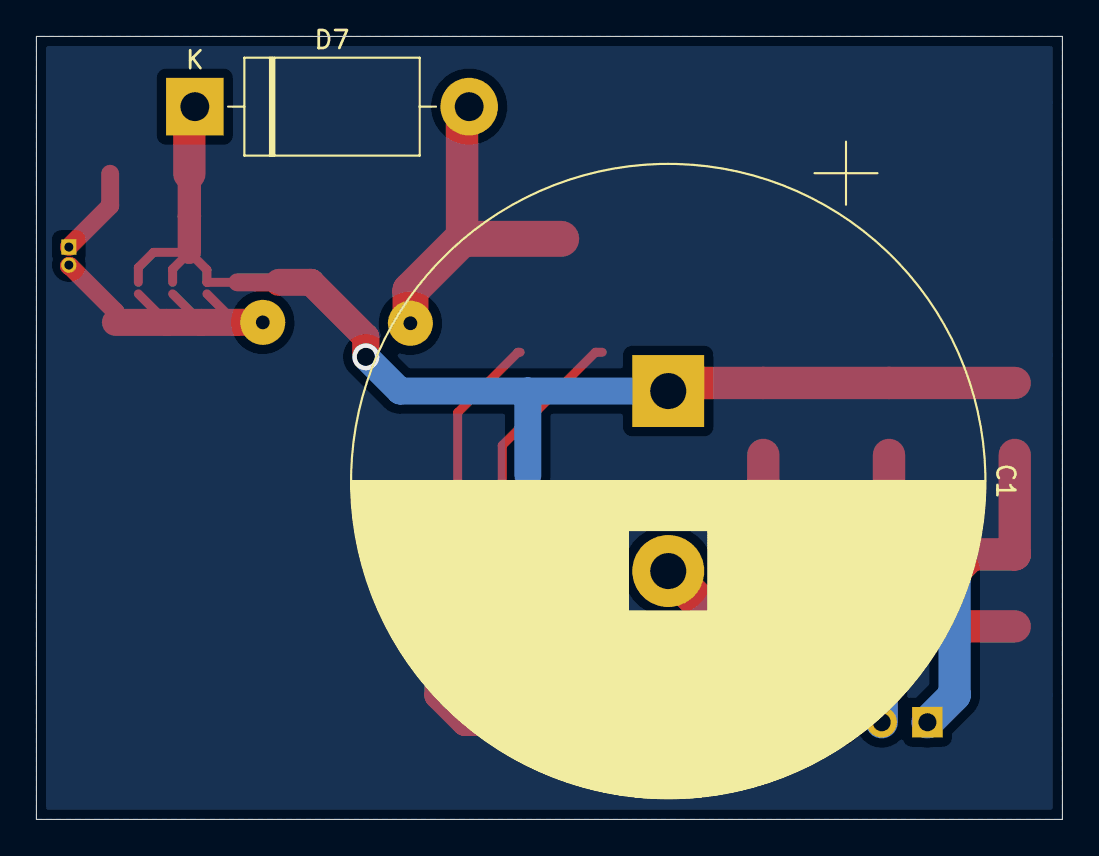
[picture p122: board EE463PCB_3.kicad_pcb from below]

Board: 2 copper layers, 57.0 x 43.5 mm, 21 parts (2 on the bottom side), 12 nets.

Parts:
C1: CP1; CP_Radial_D35.0mm_P10.00mm_SnapIn
C2: CP1; C_0402_1005Metric
C3, C4, C5: CP1; C_0201_0603Metric
D1, D2, D3, D4, D5, D6: US1G; D_SMA
D7: UF5404-E3/54; D_DO-201AD_P15.24mm_Horizontal
D8: PMEG6030EP,115; D_SOD-128
J1: Conn_01x03; PinSocket_1x03_P2.54mm_Vertical
J2: Conn_01x02; PinSocket_1x02_P1.00mm_Vertical
L1: L; T106-3_Inductor
Q1: IPD50R650CE; TO-252-2
R1: R; R_1210_3225Metric
R2: R; R_2010_5025Metric
R3: R; R_0805_2012Metric
U1: HV9961LG-G; SOIC-8_3.9x4.9mm_P1.27mm

Connections:
GND: C1.2, C2.2, D2.2, D4.2, D6.2, R1.2, R2.2, R3.2, U1.3
unnamed: C1.1, C3.1, C4.1, C5.1, D1.1, D3.1, D5.1, D7.1, D8.2, U1.1
unnamed: C2.1, R3.1
unnamed: C3.2, C4.2, C5.2, J2.2, L1.2
unnamed: D1.2, D2.1, J1.1
unnamed: D3.2, D4.1, J1.2
unnamed: D5.2, D6.1, J1.3
unnamed: D7.2, L1.1, Q1.2
unnamed: D8.1, J2.1
unnamed: Q1.1, U1.4
unnamed: Q1.3, R2.1, U1.2, U1.5, U1.6, U1.7
unnamed: R1.1, U1.8
