busranurkocak/EE463-Term-Project/(commit log)

2020-11-29 E-mail about Battery Charging
2020-12-05 The first draft of battery and PID test
2020-12-09 Generator model and Diode Rectifier Works
    The analytical calculations for diode rectifier and generator have been done.
2020-12-09 Inductor and Capacitor Calculations
2020-12-09 PCB Trials are added
    [Malzeme Listesi.xlsx, RectifierTrial.kicad_pcb, RectifierTrial.sch]
2020-12-10 Example buck converter simulink file
2020-12-13 Diode Rectifier and PMSM Model
    The constructed circuit model for PMSM generator and diode rectifier can be found.
2020-12-13 A Buck converter capacitor and inductor calculator template have been added.
    [Buck_Converter_Calculations.xlsx]
2020-12-13 Vin(max) modified as 250V.
    [Buck_Converter_Calculations.xlsx]
2020-12-24 PI Controlled Buck Converter
2020-12-24 PI Controlled Buck - 50Khz - Cap. Reselected
    Buck conv. with 50 khz have been controlled with PI controller. The Capactior value in LC filter have been reselected. The ESR value calculation has taken into consideration
2020-12-25 Buck converter calculations and component selection have been added.
2020-12-25 SLX file is redesigned.
    The messy componenets are combined in subblocks for complete circuit. Kp and Ki values are defined experimentally.
    Kp shouldn't exceed 6-7 and Ki can be defined according steady state error
2020-12-25 Sw and Cond loss added to buck - Report
2021-01-08 Schematic of the PCB is uploaded
    [EE463PCB.kicad_pcb, EE463PCB.sch]
2021-01-09 New components file is updated and PCB schematic is also updated
    [EE463PCB.sch]
2021-01-11 Term Project PCB design version 1
    [EE463PCB.kicad_pcb, EE463PCB.sch]
2021-01-11 Updated PCB
    [EE463PCB.kicad_pcb, EE463PCB_2.kicad_pcb]
2021-01-14 PCB design updated.
    [EE463PCB.step, EE463PCB_3.kicad_pcb]
2021-01-14 PCB updated
    [EE463PCB.sch, EE463PCB.step, EE463PCB_2.kicad_pcb, EE463PCB_3.kicad_pcb, EE463PCB_3.sch]
2021-01-15 Explanation added for capacitor selectiıon process
2021-01-15 New component selection and BOM is added
    [BOM.xlsx, EE463PCB.sch, EE463PCB.step, EE463PCB_2.kicad_pcb, EE463PCB_3.kicad_pcb, EE463PCB_3.sch, EE463PCB_4.step]
2021-01-15 PCB filed added.
    [EE463PCB.sch, EE463PCB.step, EE463PCB_2.kicad_pcb, EE463PCB_3.kicad_pcb, EE463PCB_3.sch, EE463PCB_4.step]
2021-01-15 PCB Design explanation added.
2021-01-15 PCB report updated.
    [EE463PCB_3.kicad_pcb, EE463PCB_5.step]
2021-01-21 Some files for presentation is uploaded
    [EE463PCB_3.sch]
